letrend/UVen/docs/photo_2023-08-14_19-41-47.jpg

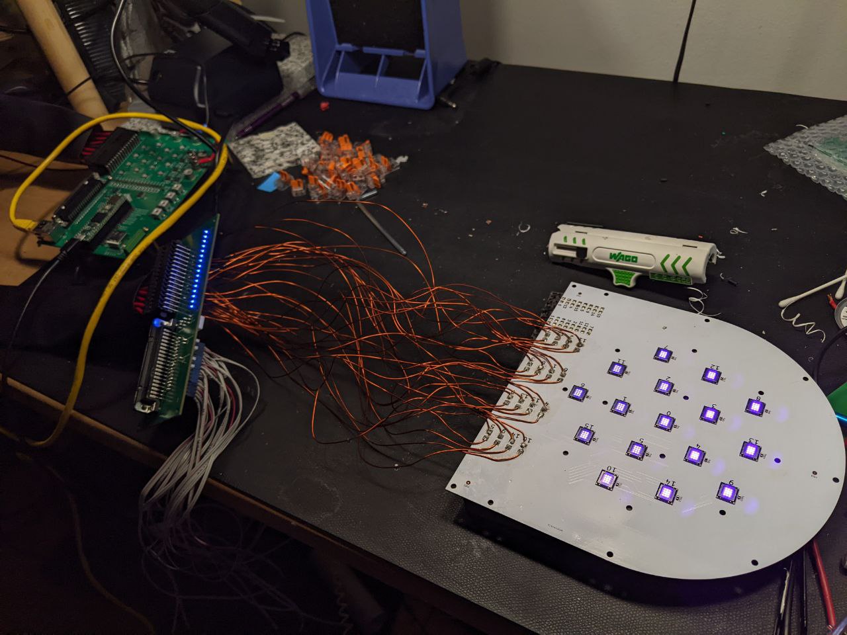
docs/photo_2023-08-14_19-41-47.jpg
