letrend/UVen/docs/photo_2023-08-14_15-02-16.jpg

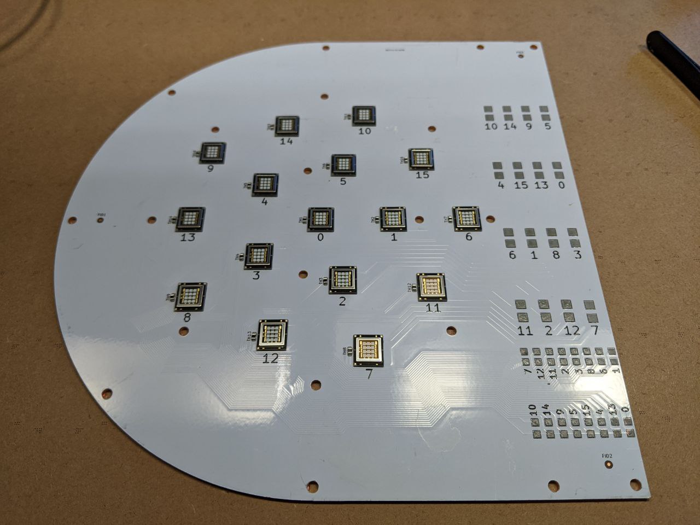
docs/photo_2023-08-14_15-02-16.jpg
