letrend/UVen/README.md

# UVen
UV irradiation system for enhanced photo-activation in living cells
