letrend/UVen/docs/1A.png

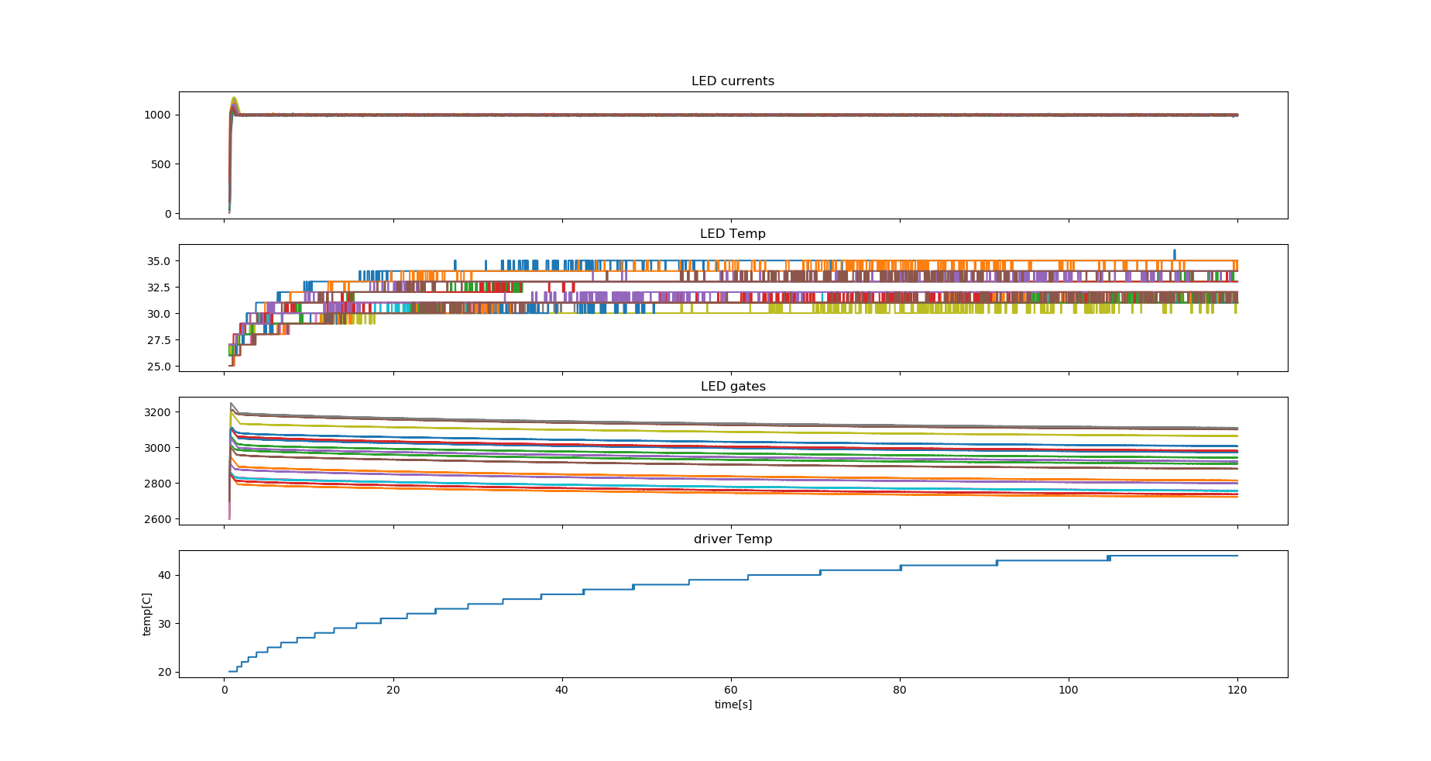
docs/1A.png
