letrend/UVen/docs/2A.png

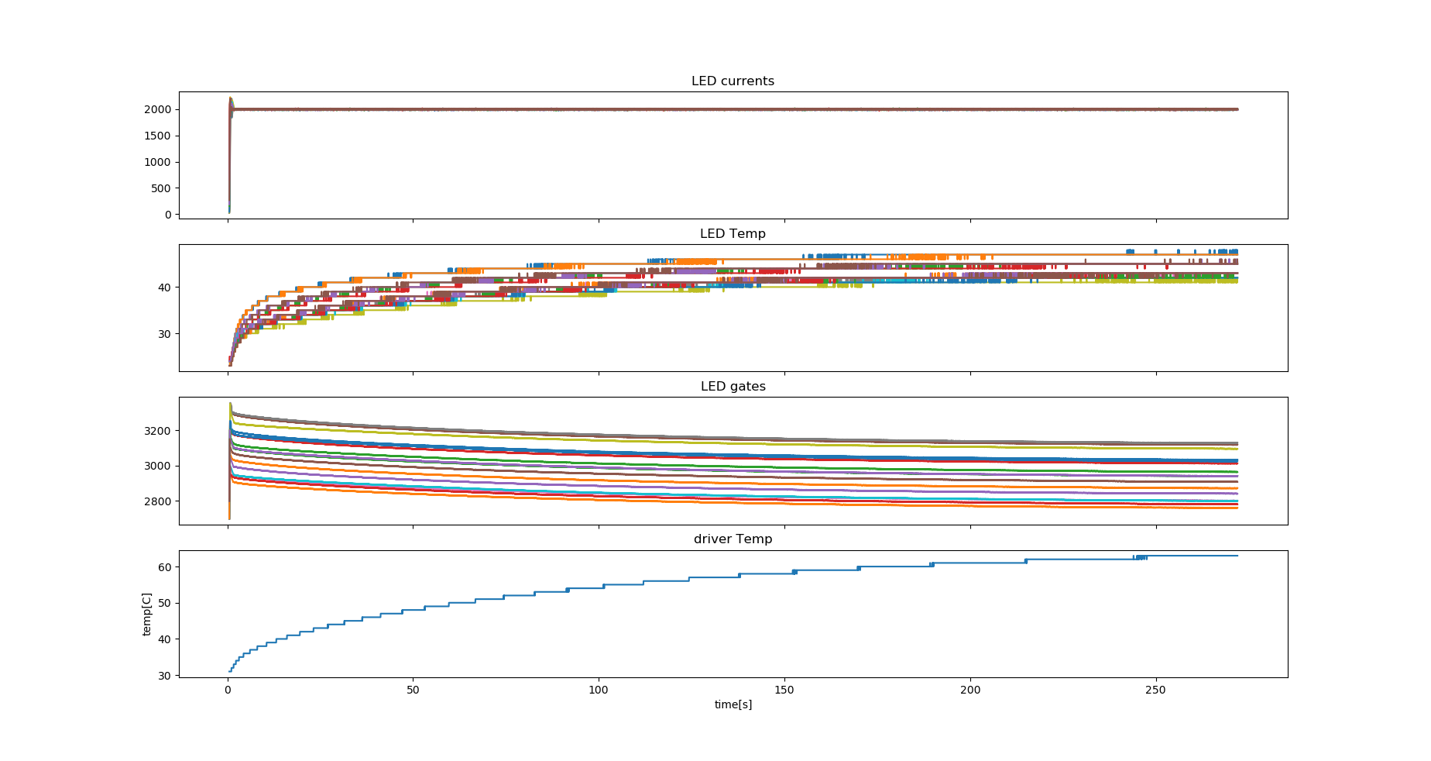
docs/2A.png
