letrend/UVen/docs/display_control.png

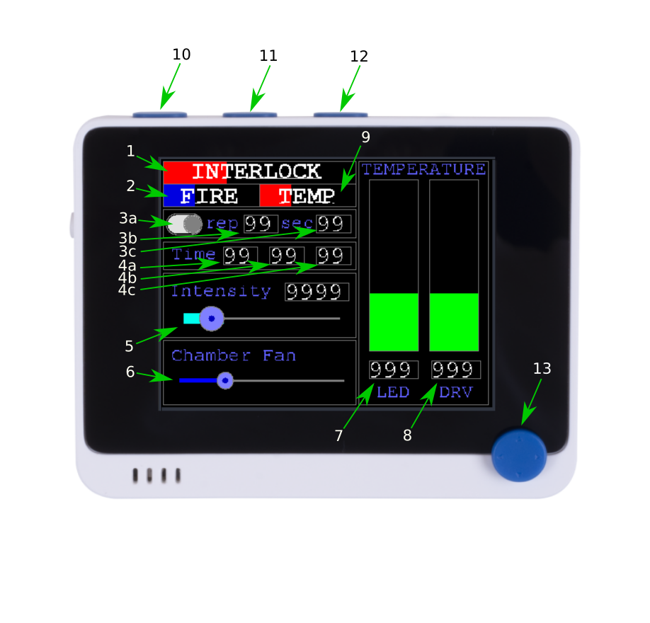
docs/display_control.png
