letrend/UVen/docs/max.png

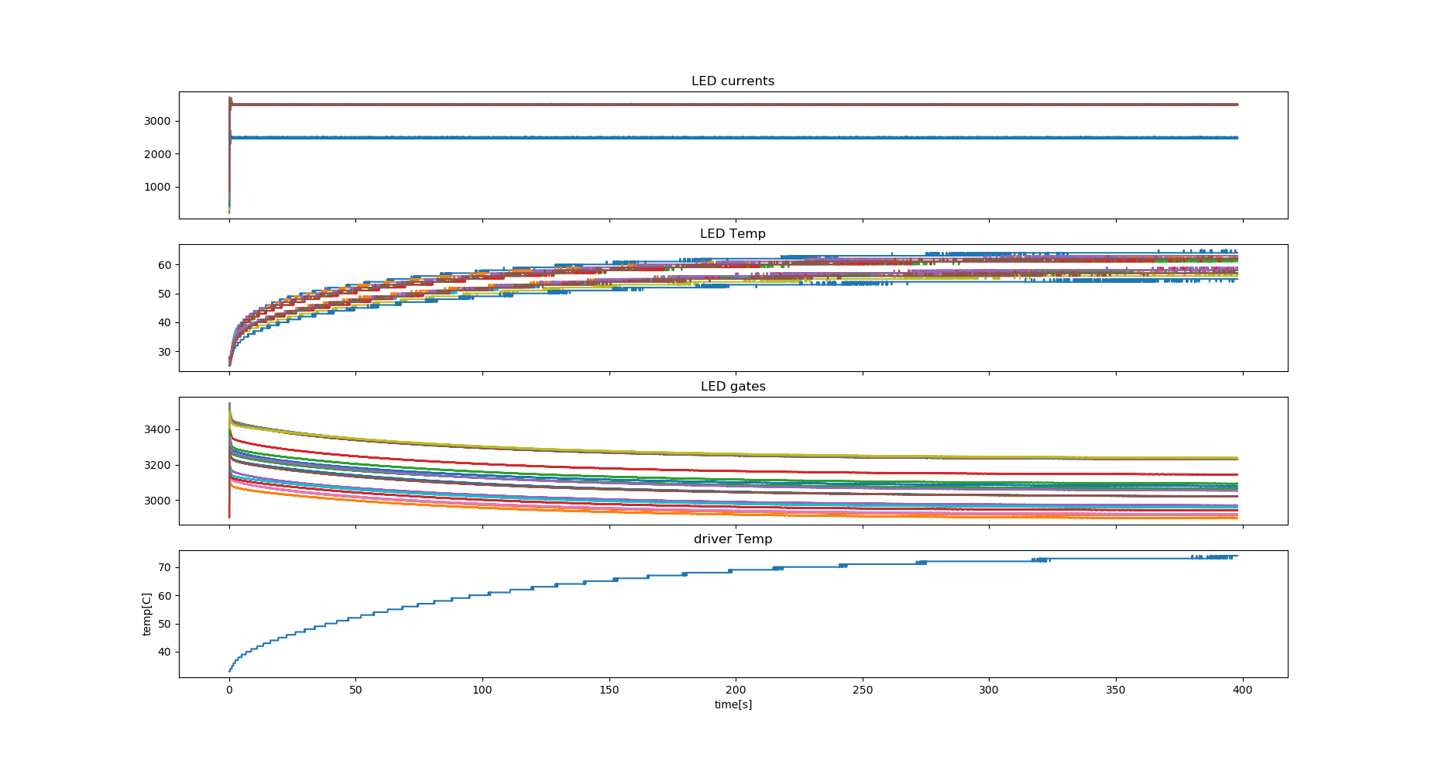
docs/max.png
