letrend/UVen/docs/overTempProtection.png

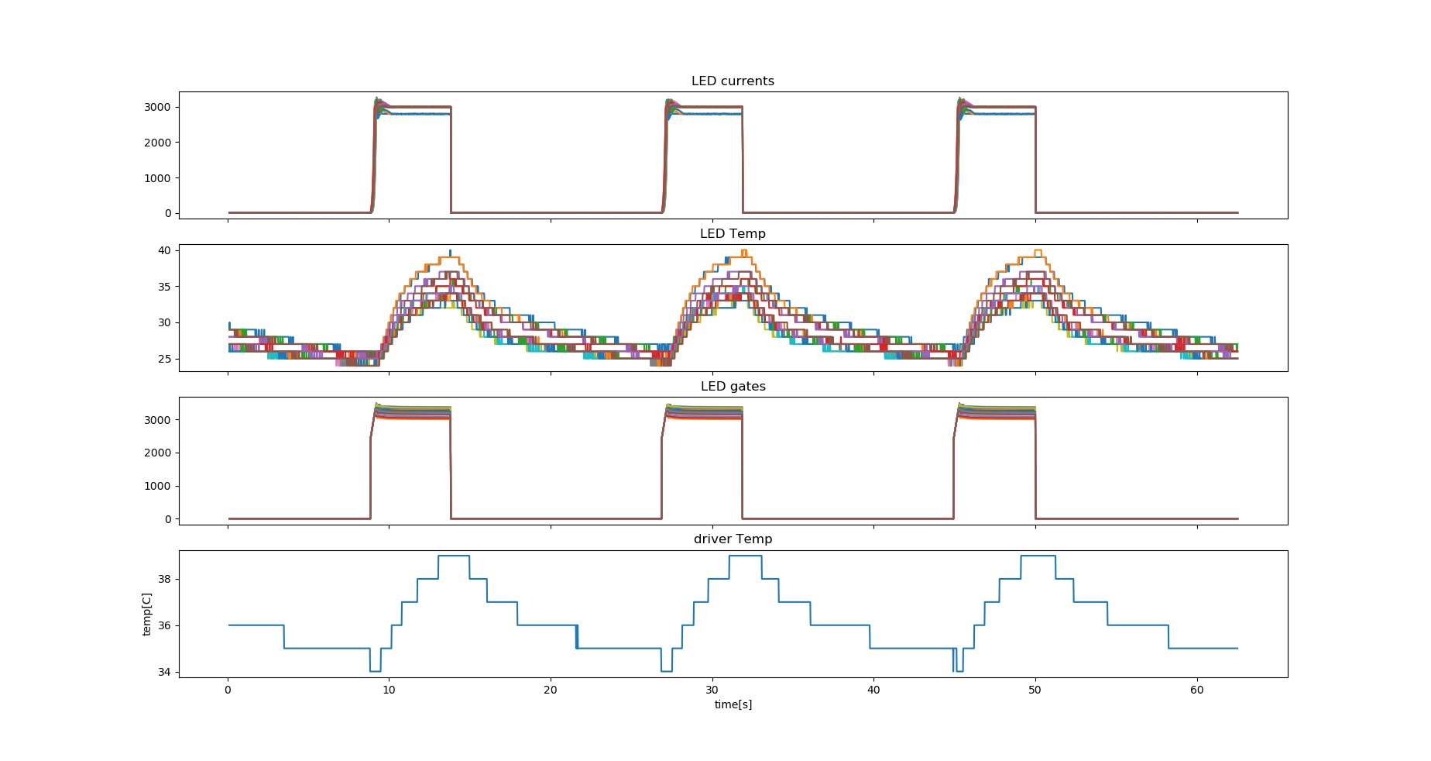
docs/overTempProtection.png
