letrend/UVen/docs/photo_2023-07-25_22-31-44.jpg

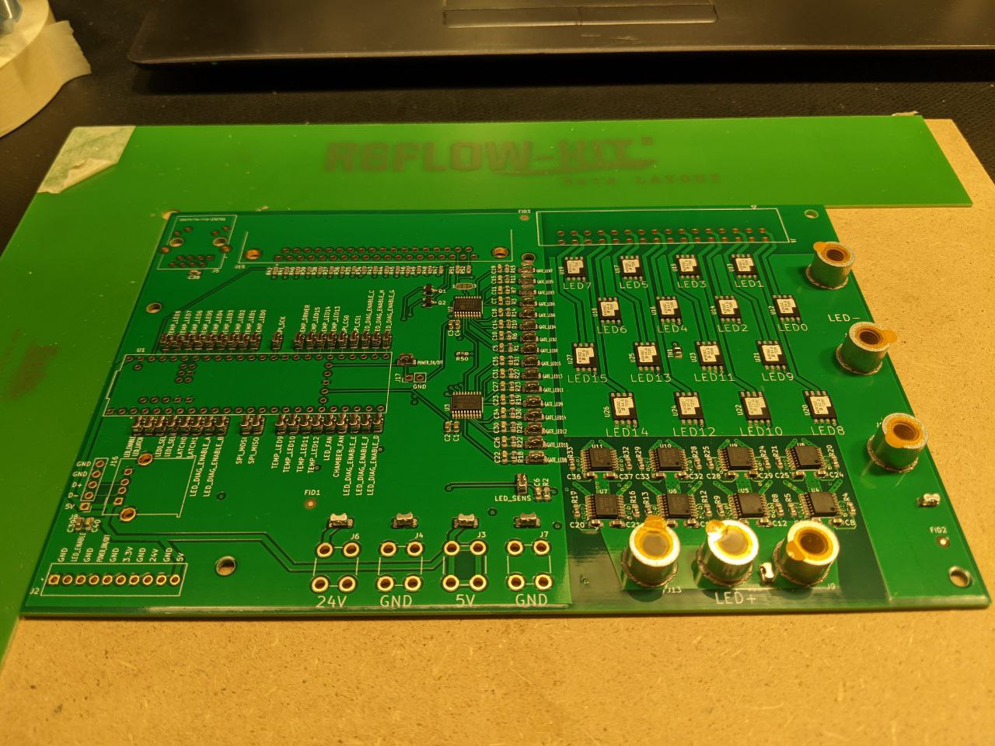
docs/photo_2023-07-25_22-31-44.jpg
