letrend/UVen/docs/photo_2023-07-28_22-57-53.jpg

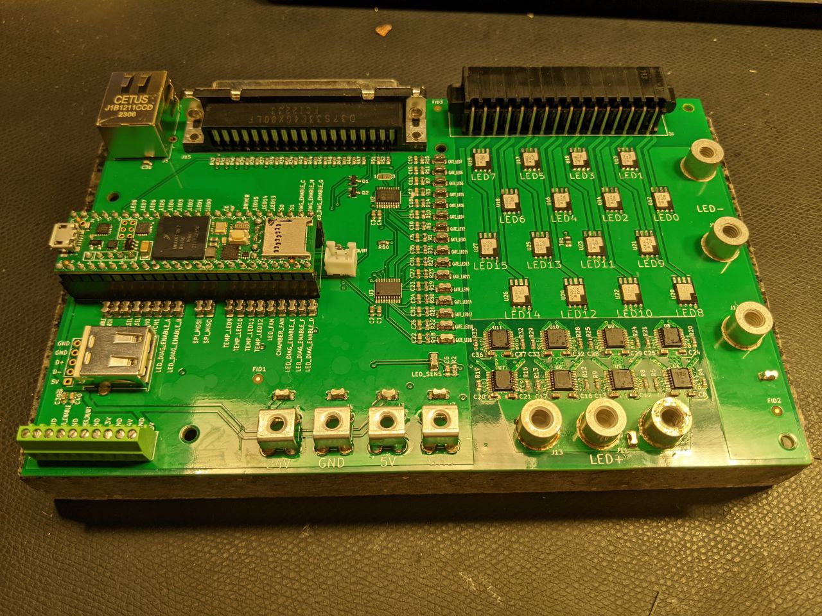
docs/photo_2023-07-28_22-57-53.jpg
