letrend/UVen/docs/photo_2023-07-29_12-32-24.jpg

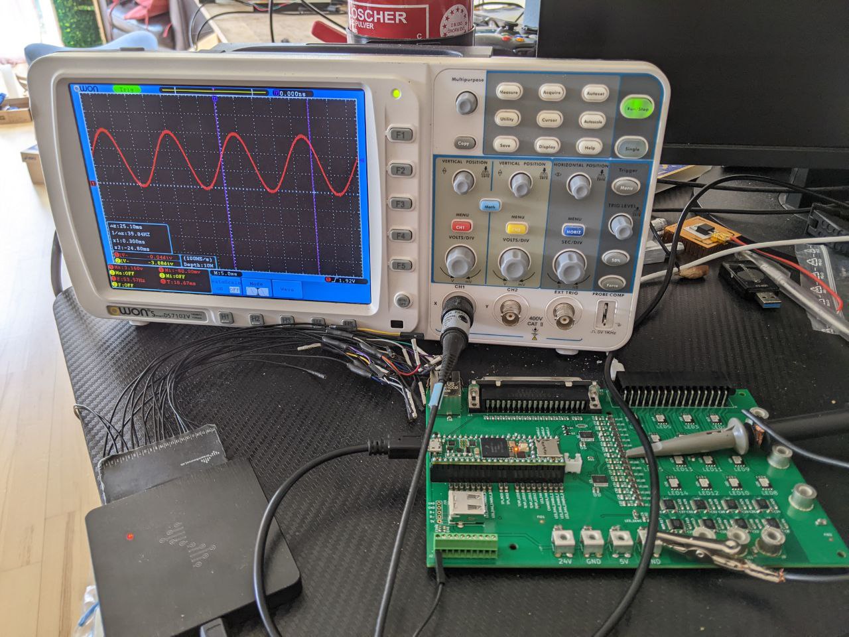
docs/photo_2023-07-29_12-32-24.jpg
