letrend/UVen/docs/photo_2023-07-29_15-54-59.jpg

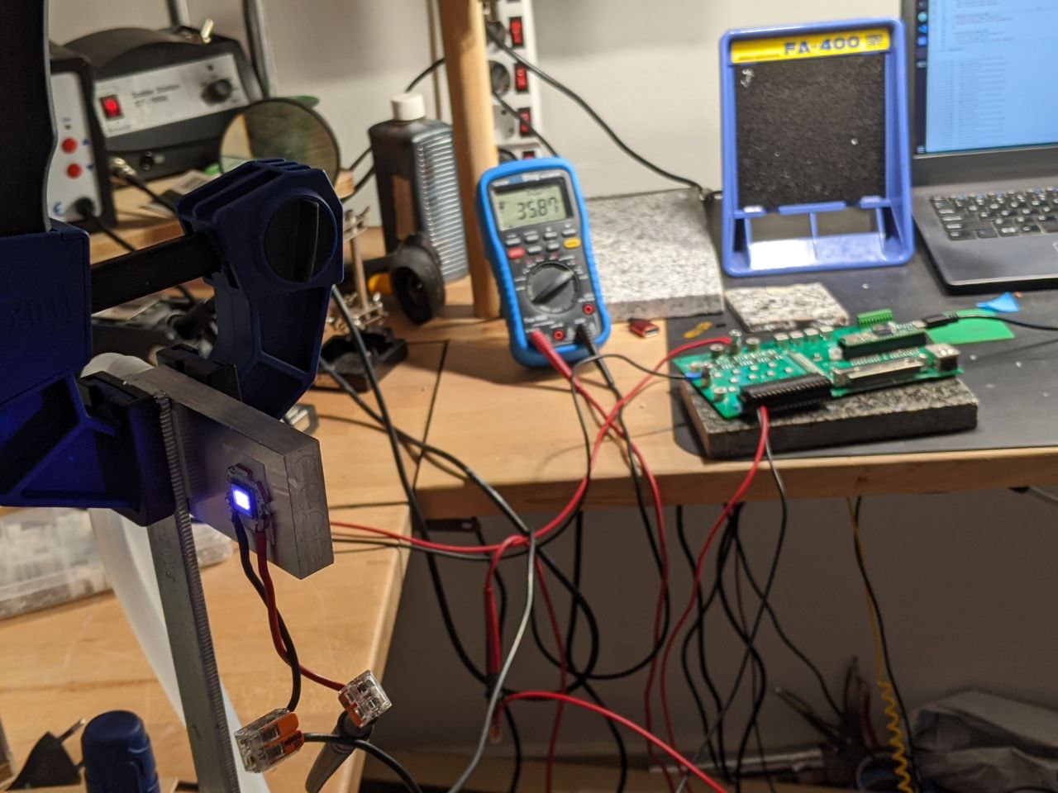
docs/photo_2023-07-29_15-54-59.jpg
