letrend/UVen/docs/photo_2023-07-31_22-14-31.jpg

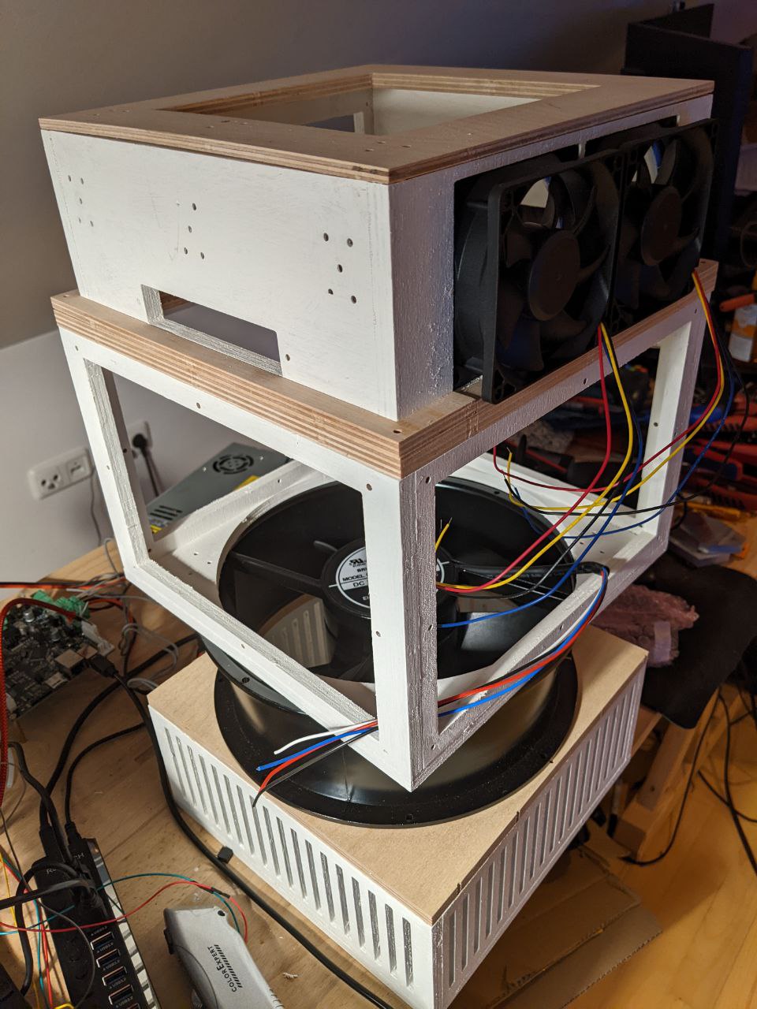
docs/photo_2023-07-31_22-14-31.jpg
