letrend/UVen/docs/photo_2023-08-09_19-29-06 (2).jpg

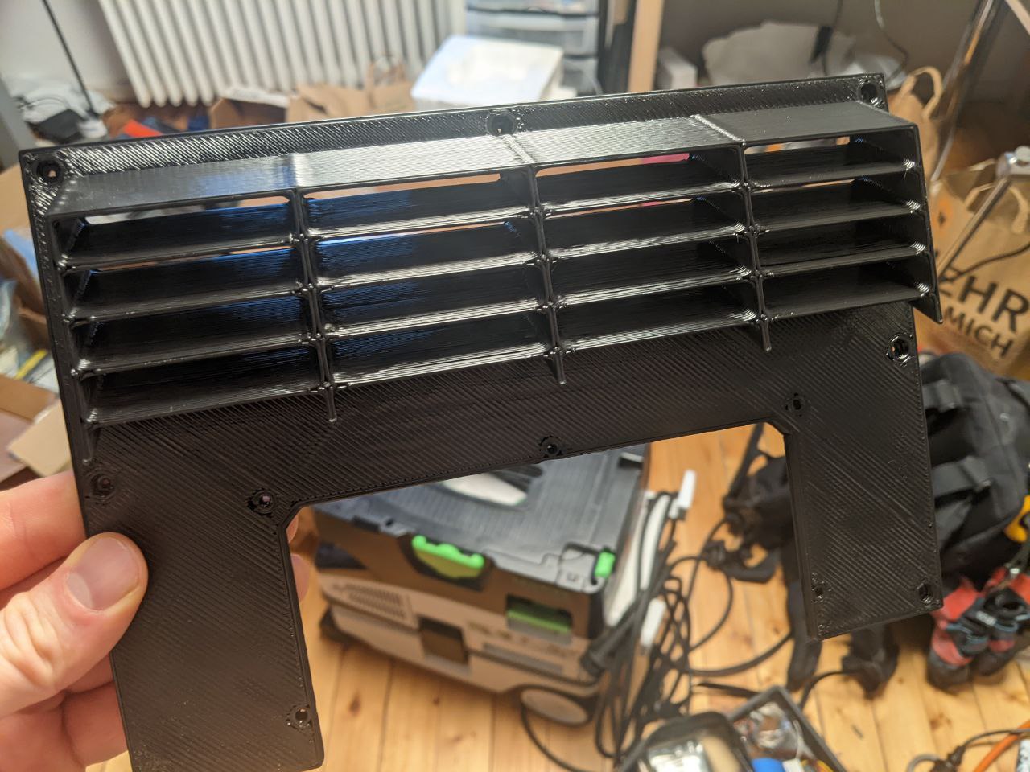
docs/photo_2023-08-09_19-29-06 (2).jpg
