letrend/UVen/docs/photo_2023-08-09_19-29-06.jpg

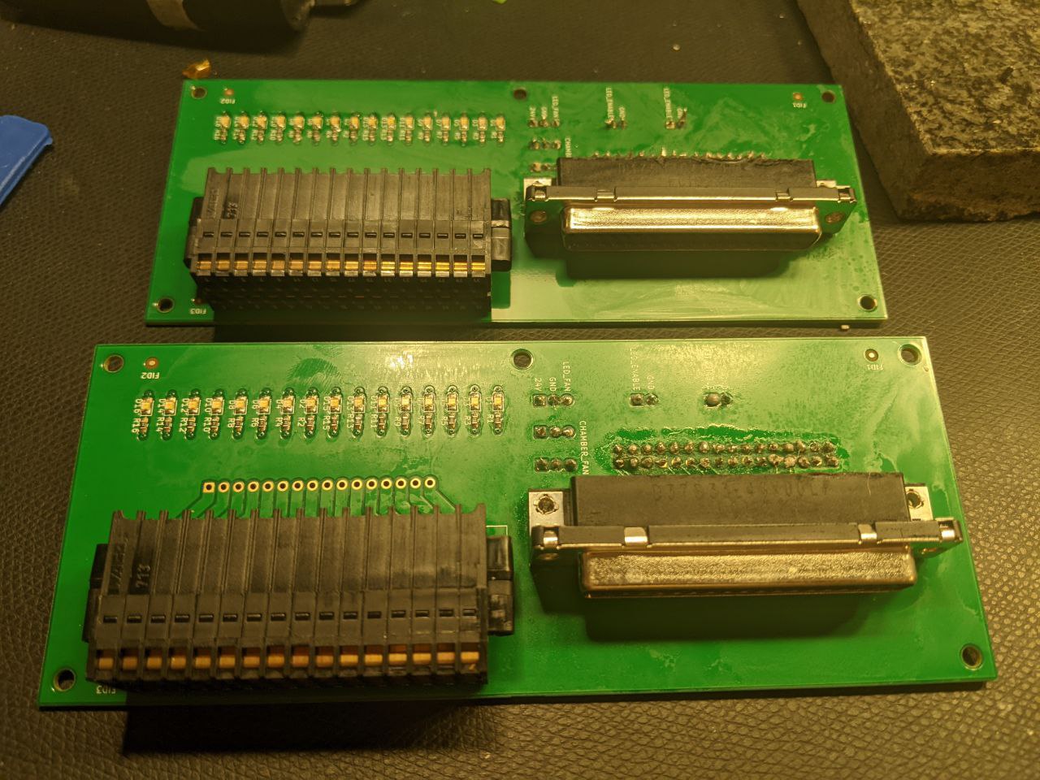
docs/photo_2023-08-09_19-29-06.jpg
