letrend/UVen/docs/photo_2023-08-09_21-17-47.jpg

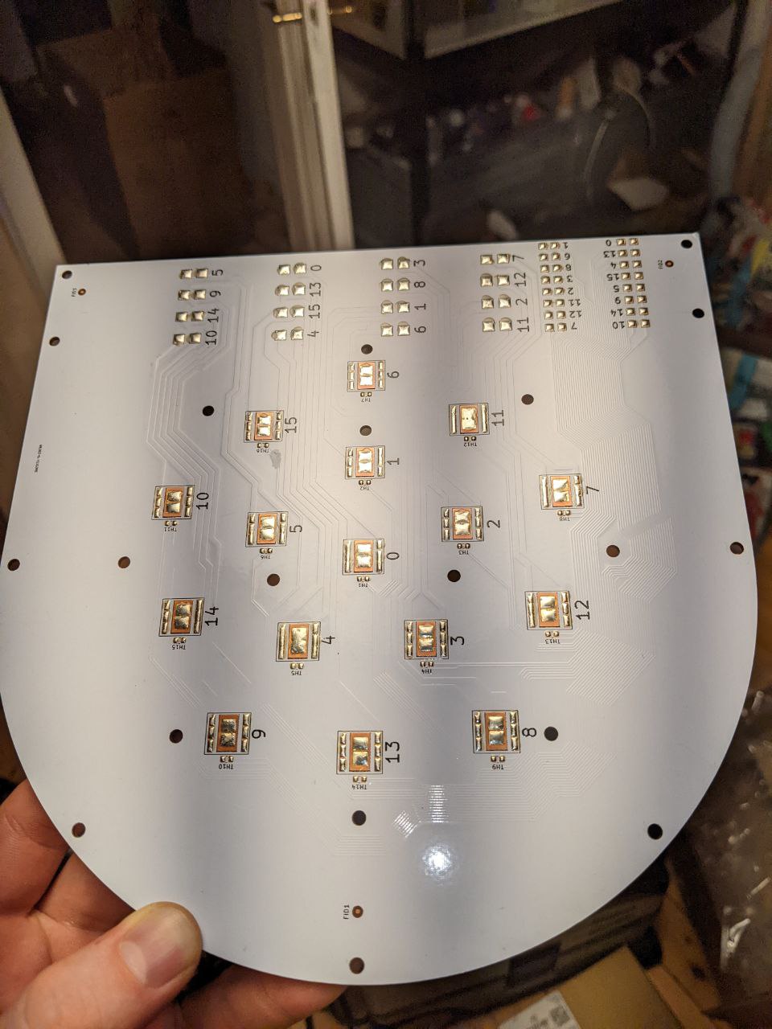
docs/photo_2023-08-09_21-17-47.jpg
