letrend/UVen/docs/photo_2023-08-14_11-19-50.jpg

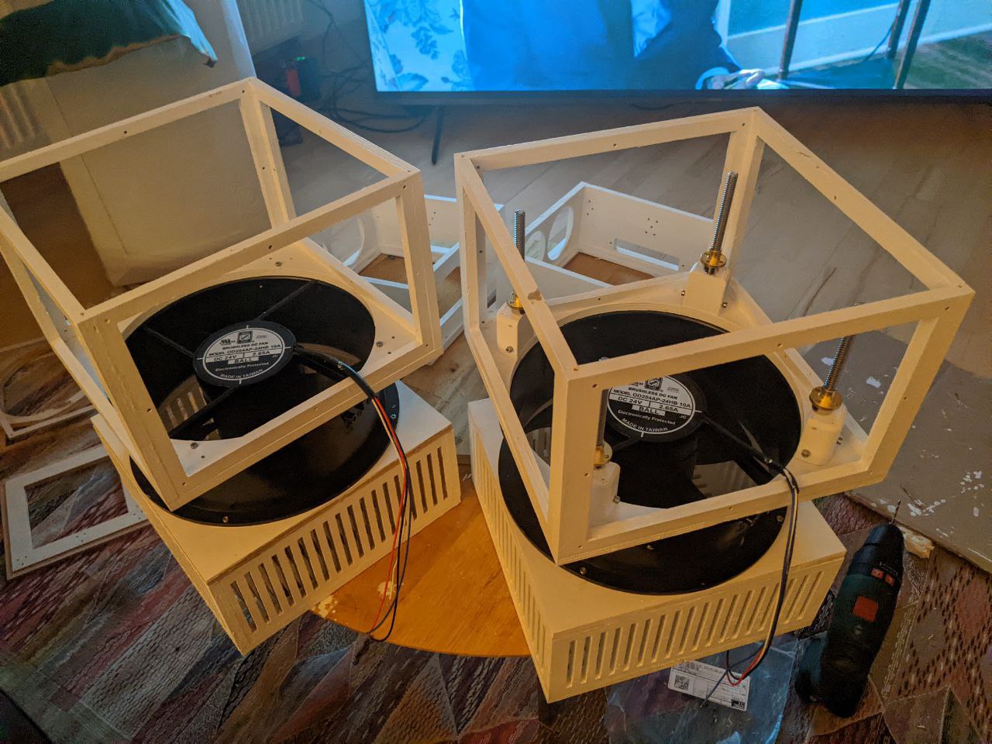
docs/photo_2023-08-14_11-19-50.jpg
