letrend/UVen/docs/photo_2023-08-14_11-21-11.jpg

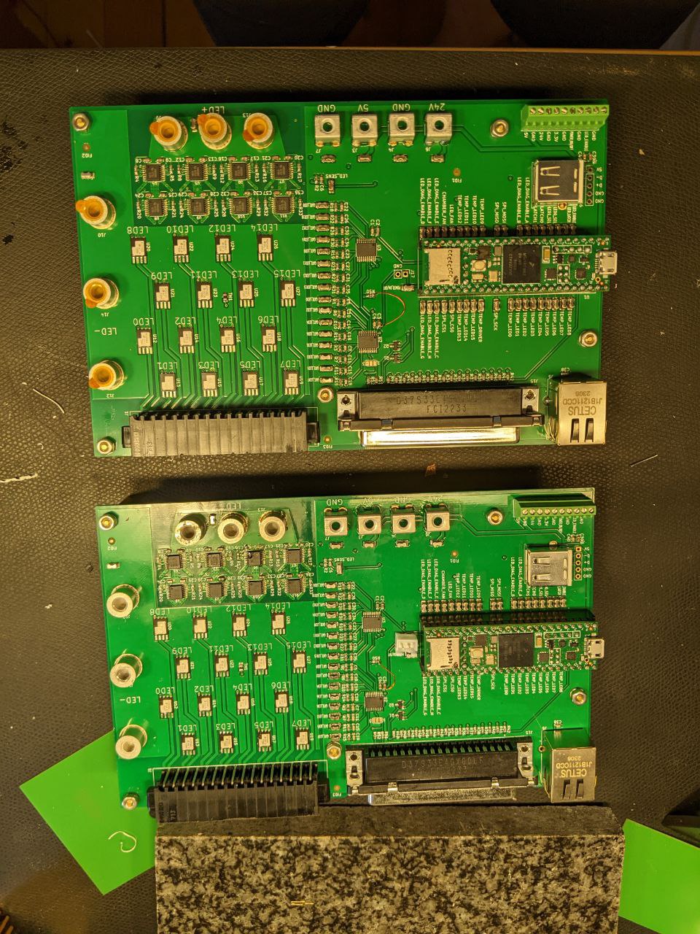
docs/photo_2023-08-14_11-21-11.jpg
