letrend/UVen/docs/photo_2023-08-14_14-28-31.jpg

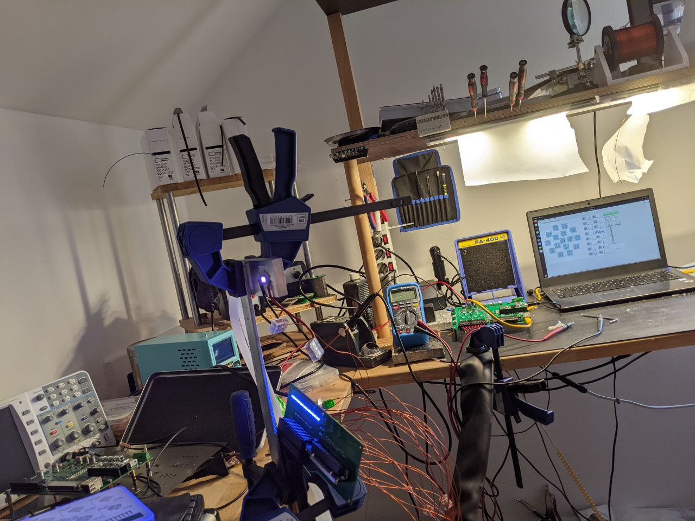
docs/photo_2023-08-14_14-28-31.jpg
