letrend/UVen/docs/photo_2023-08-15_13-29-59 (2).jpg

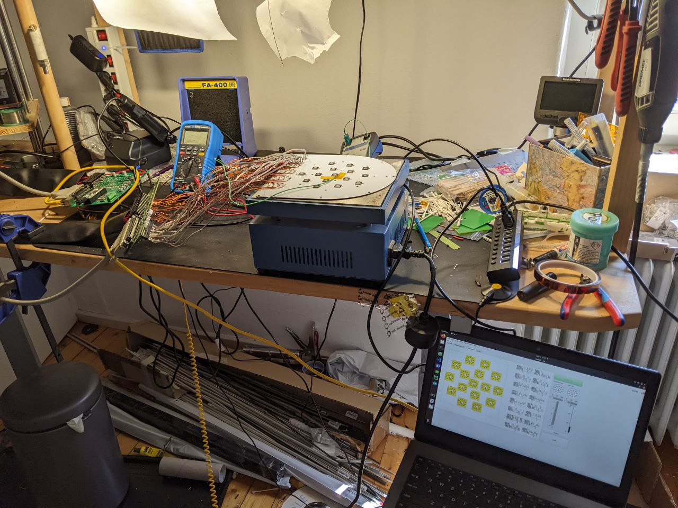
docs/photo_2023-08-15_13-29-59 (2).jpg
