letrend/UVen/docs/photo_2023-08-15_15-07-47.jpg

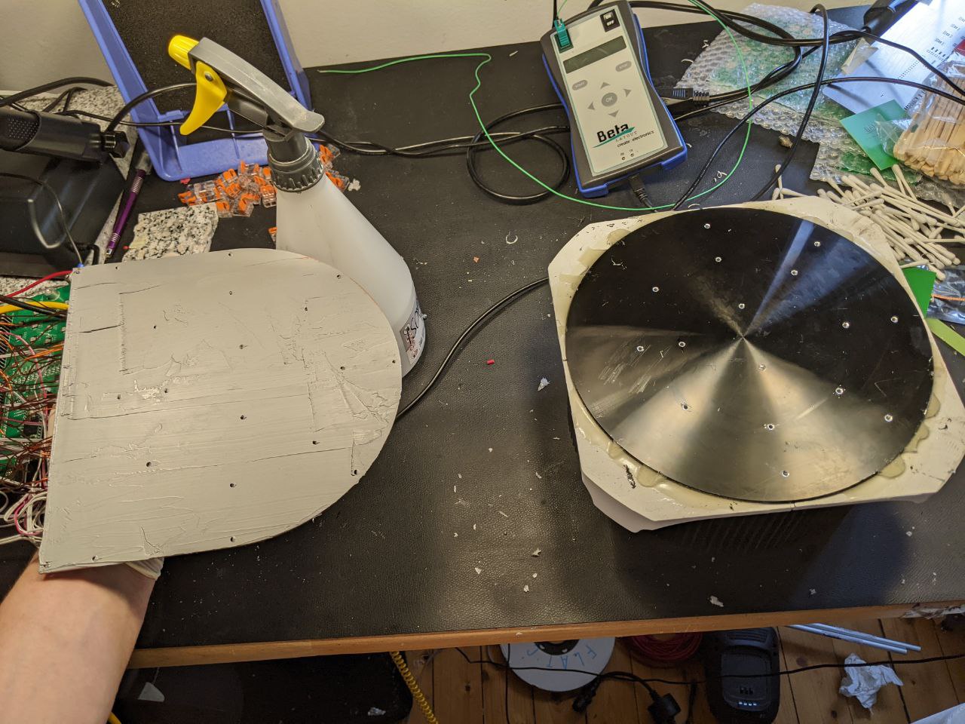
docs/photo_2023-08-15_15-07-47.jpg
