letrend/UVen/docs/photo_2023-08-15_15-56-15.jpg

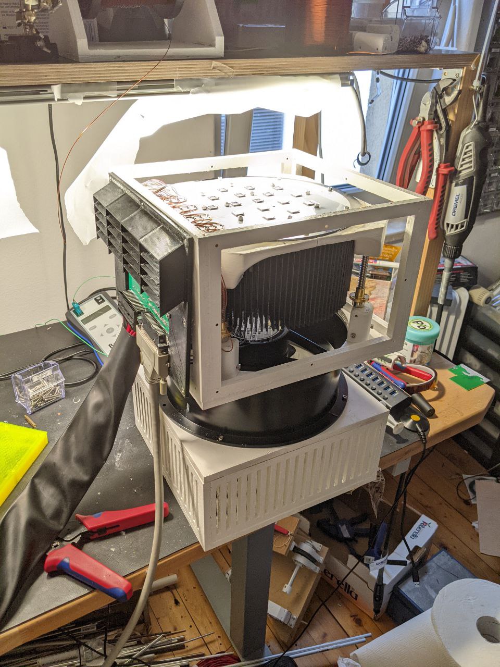
docs/photo_2023-08-15_15-56-15.jpg
