letrend/UVen/docs/photo_2023-08-15_16-40-28.jpg

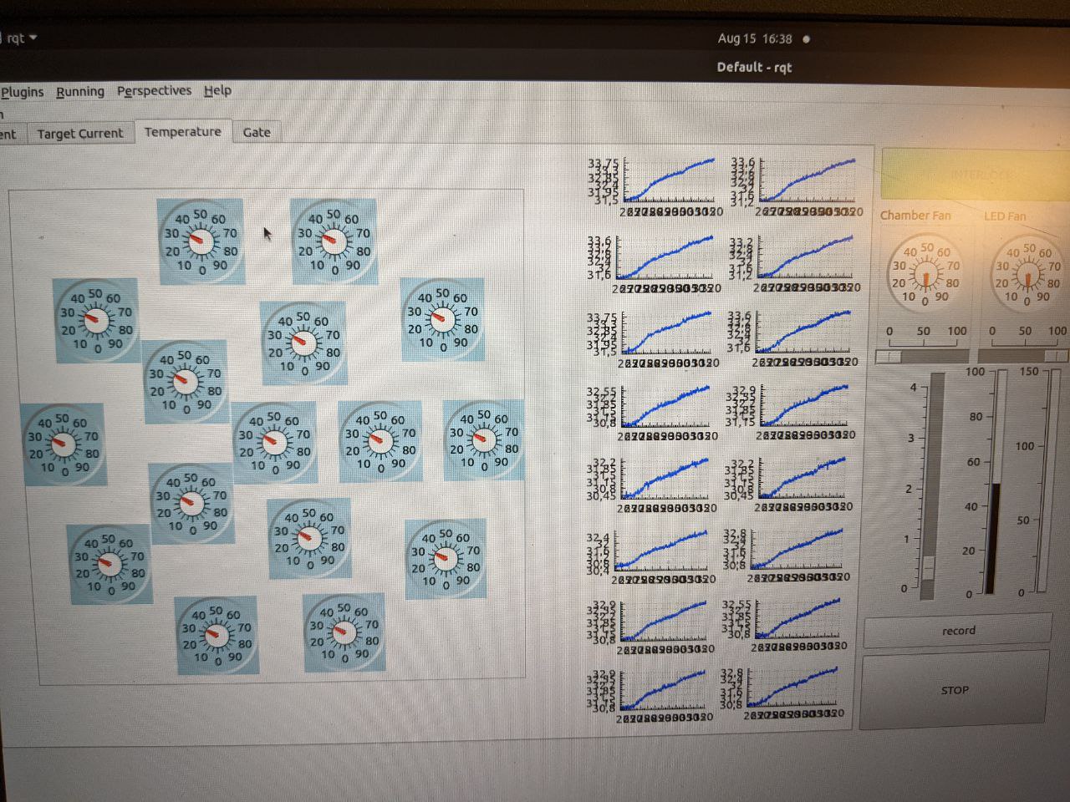
docs/photo_2023-08-15_16-40-28.jpg
