letrend/UVen/docs/photo_2023-08-15_18-18-40 (2).jpg

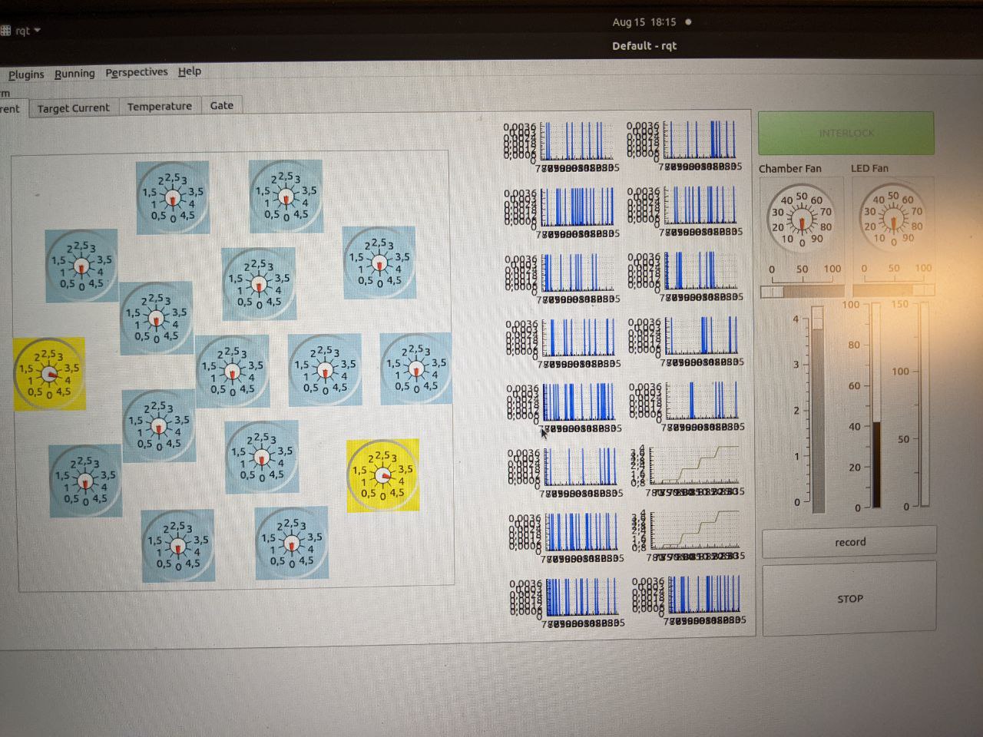
docs/photo_2023-08-15_18-18-40 (2).jpg
