letrend/UVen/docs/photo_2023-08-15_19-15-47.jpg

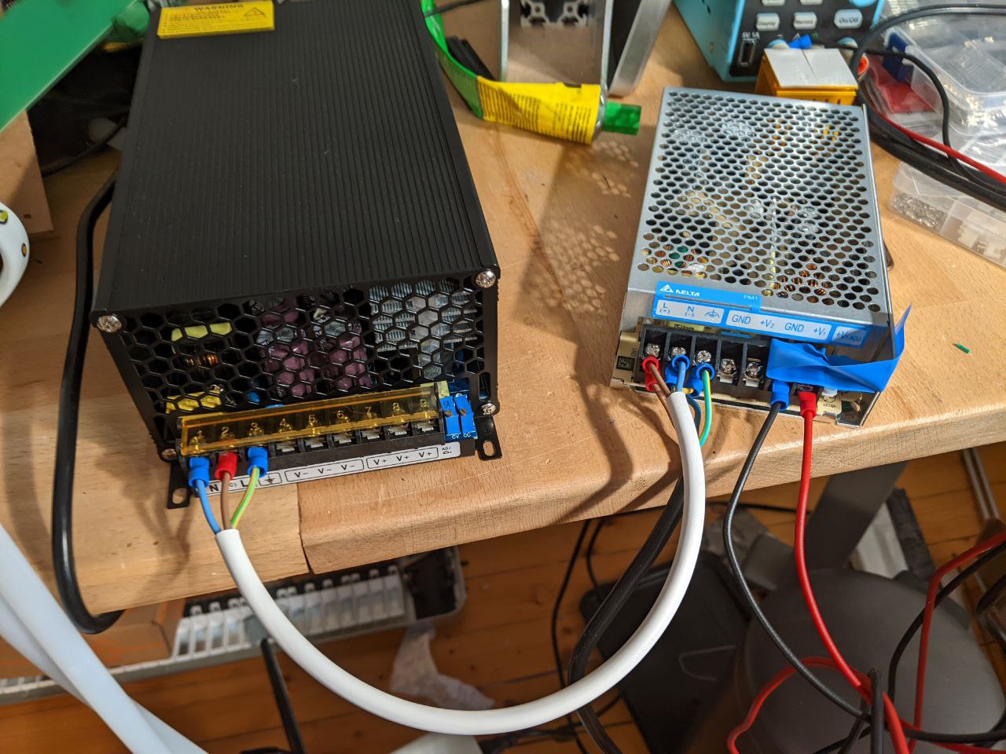
docs/photo_2023-08-15_19-15-47.jpg
