letrend/UVen/docs/photo_2023-08-16_20-38-40.jpg

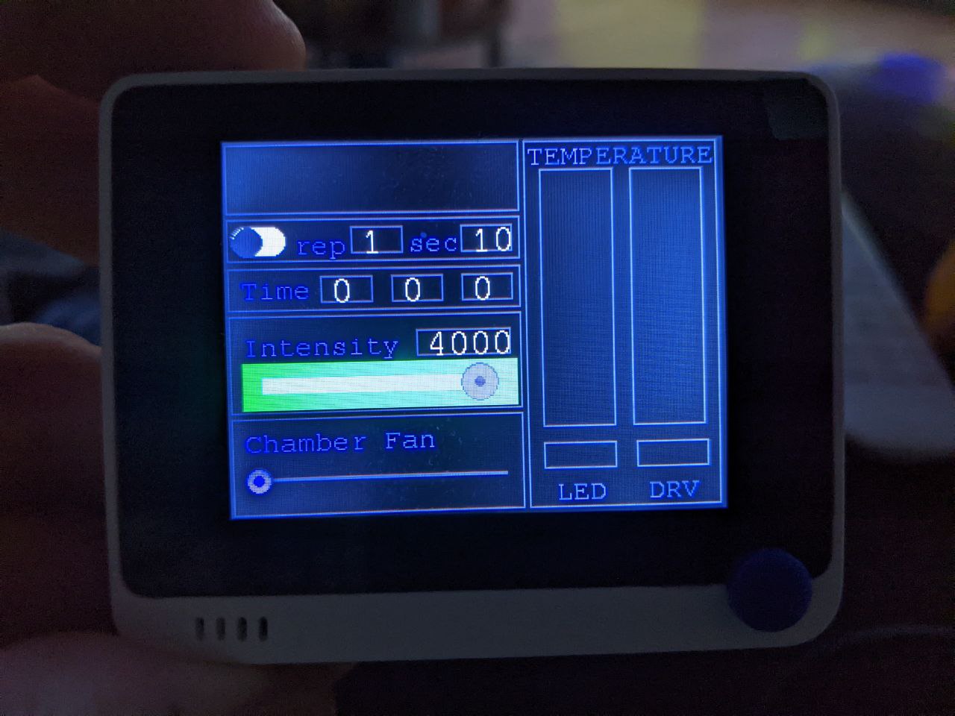
docs/photo_2023-08-16_20-38-40.jpg
