letrend/UVen/docs/photo_2023-08-20_18-25-43.jpg

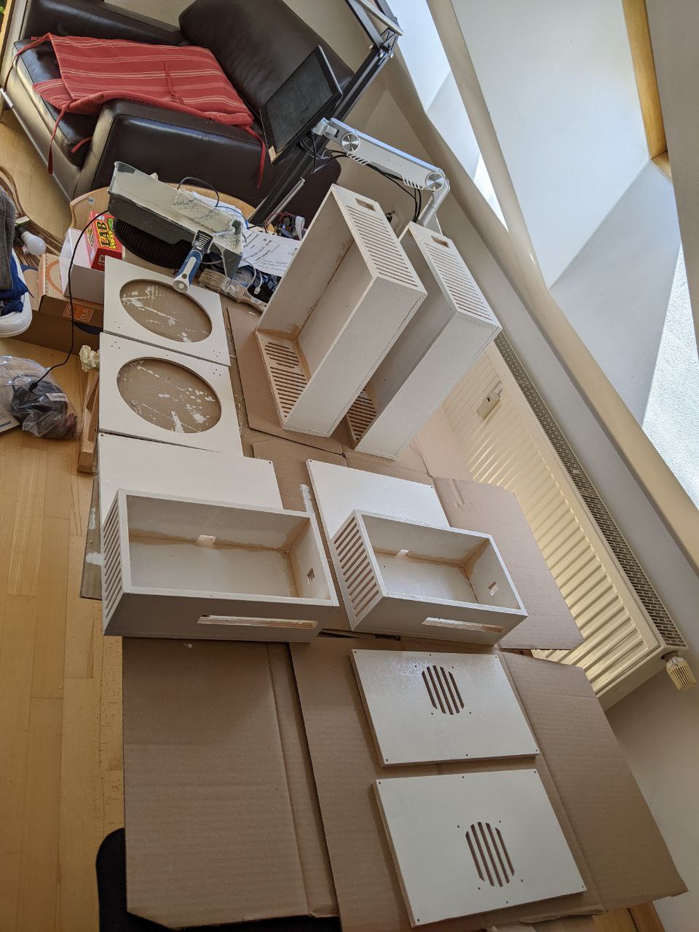
docs/photo_2023-08-20_18-25-43.jpg
