letrend/UVen/docs/photo_2023-08-20_20-09-37.jpg

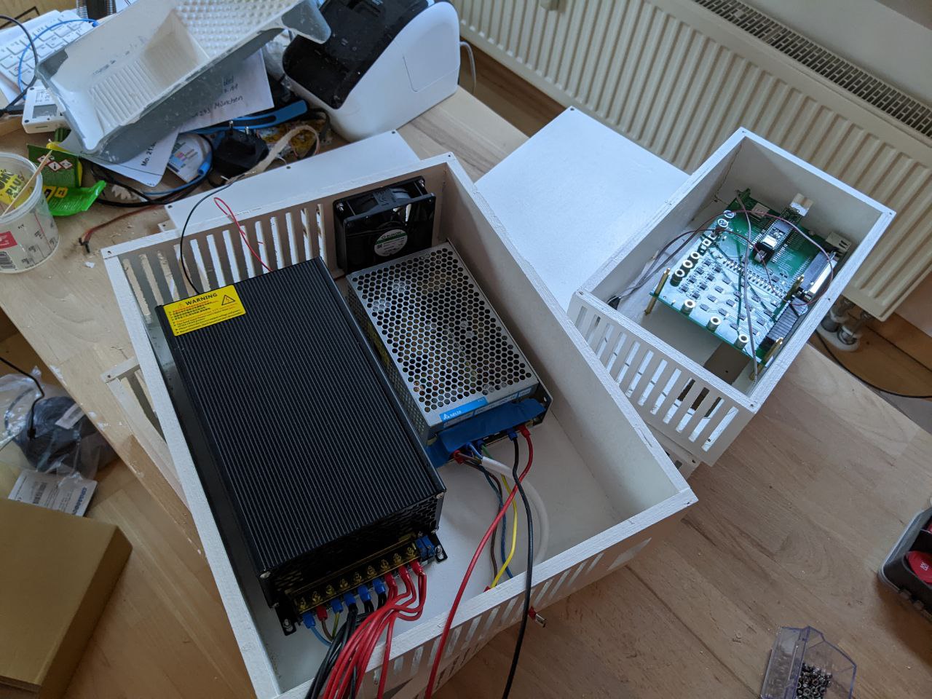
docs/photo_2023-08-20_20-09-37.jpg
