letrend/UVen/docs/photo_2023-08-22_20-38-16.jpg

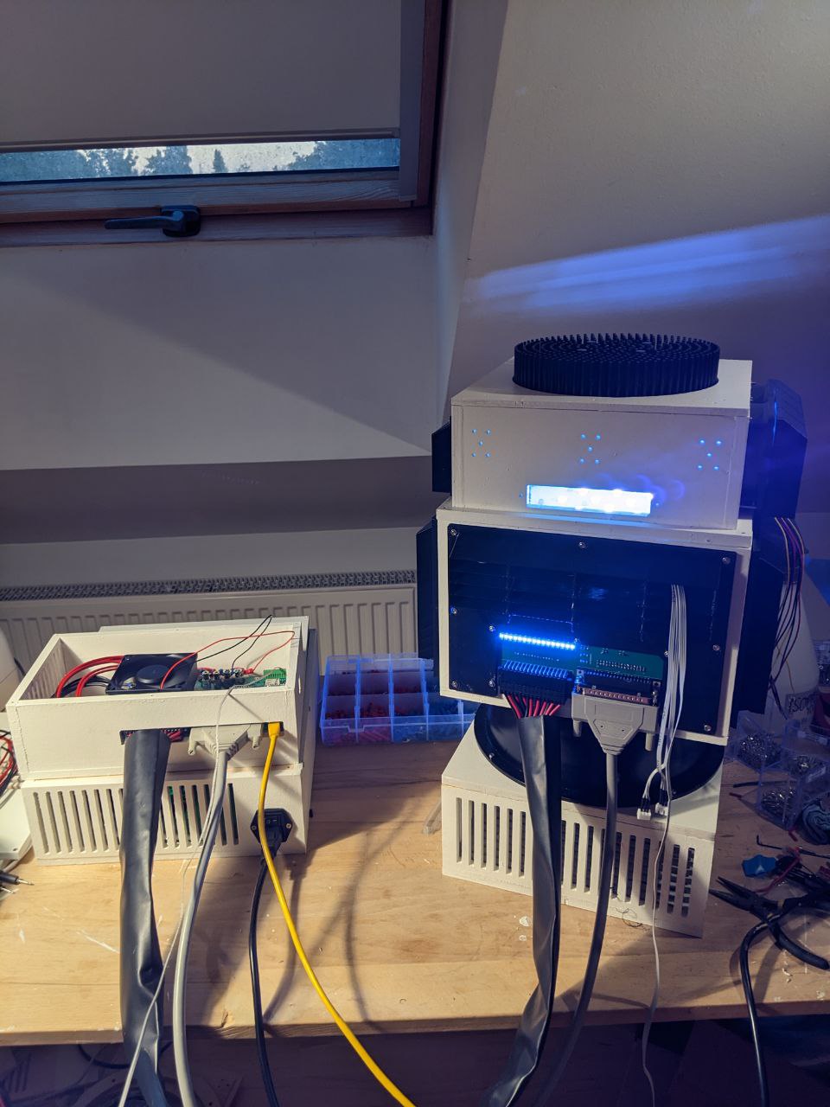
docs/photo_2023-08-22_20-38-16.jpg
