letrend/UVen/docs/photo_2023-08-26_19-12-46.jpg

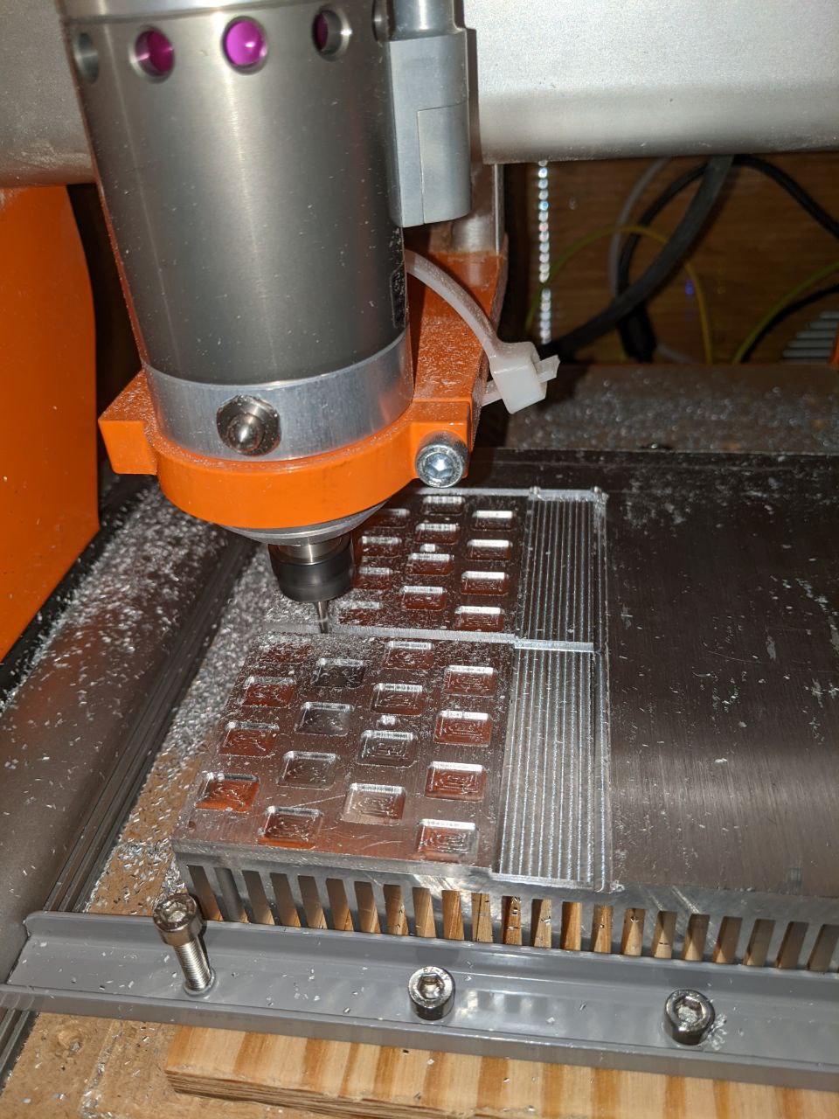
docs/photo_2023-08-26_19-12-46.jpg
