letrend/UVen/docs/photo_2023-08-26_20-18-00 (2).jpg

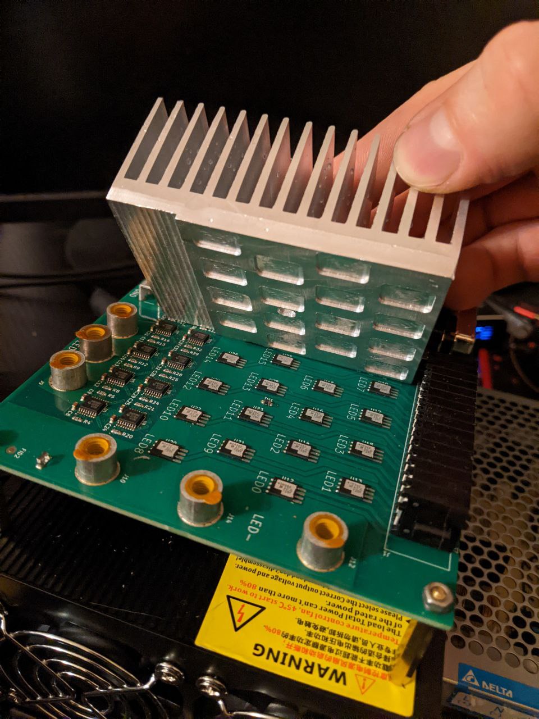
docs/photo_2023-08-26_20-18-00 (2).jpg
