letrend/UVen/docs/photo_2023-08-26_20-18-00.jpg

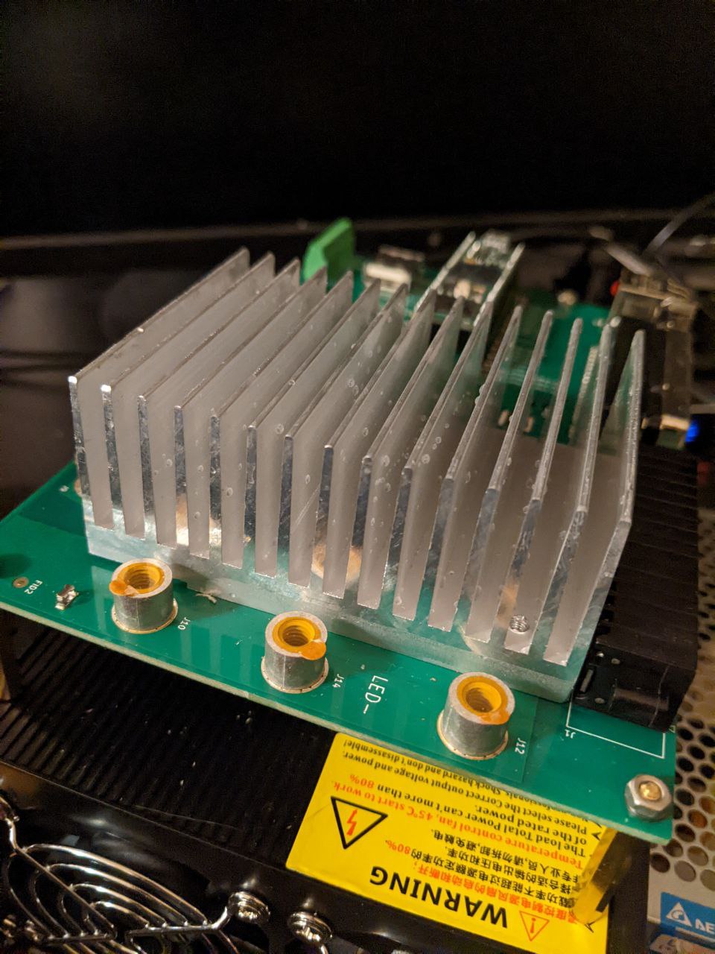
docs/photo_2023-08-26_20-18-00.jpg
