letrend/UVen/docs/photo_2023-08-26_23-55-58.jpg

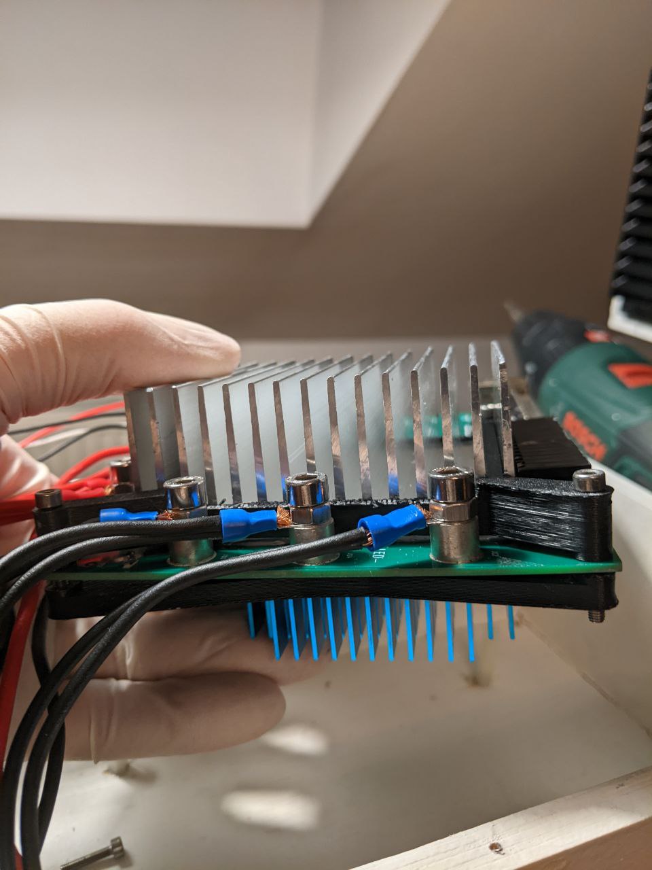
docs/photo_2023-08-26_23-55-58.jpg
