letrend/UVen/docs/photo_2023-08-27_11-00-27.jpg

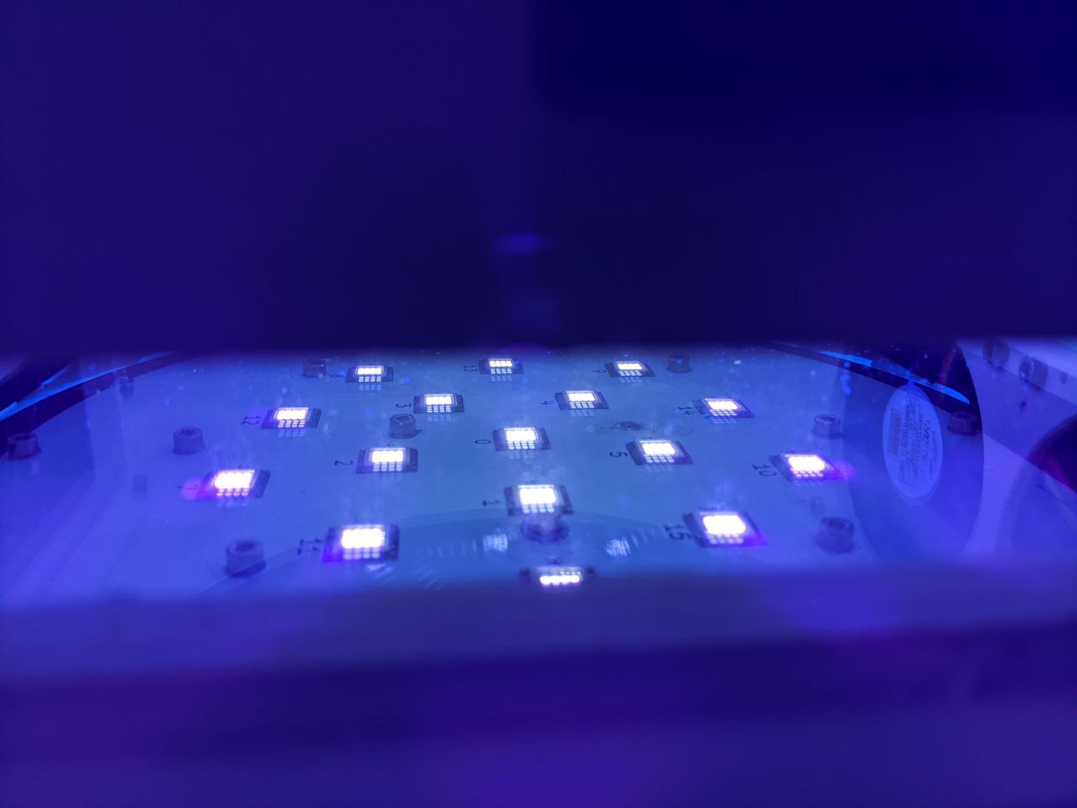
docs/photo_2023-08-27_11-00-27.jpg
