letrend/UVen/docs/photo_2023-08-27_14-05-15.jpg

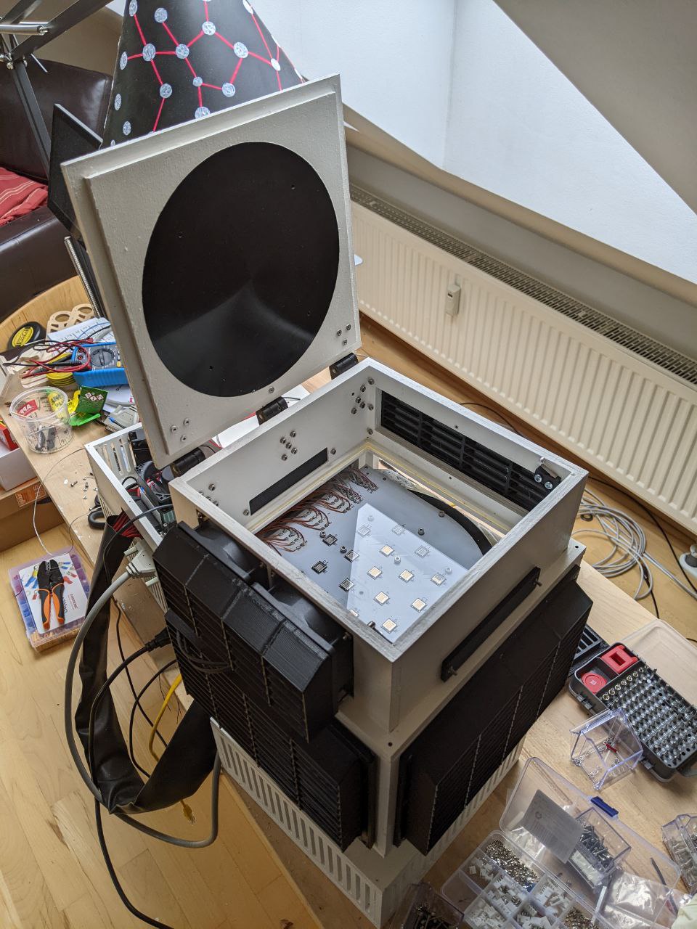
docs/photo_2023-08-27_14-05-15.jpg
