letrend/UVen/docs/photo_2023-08-27_18-15-50(3).jpg

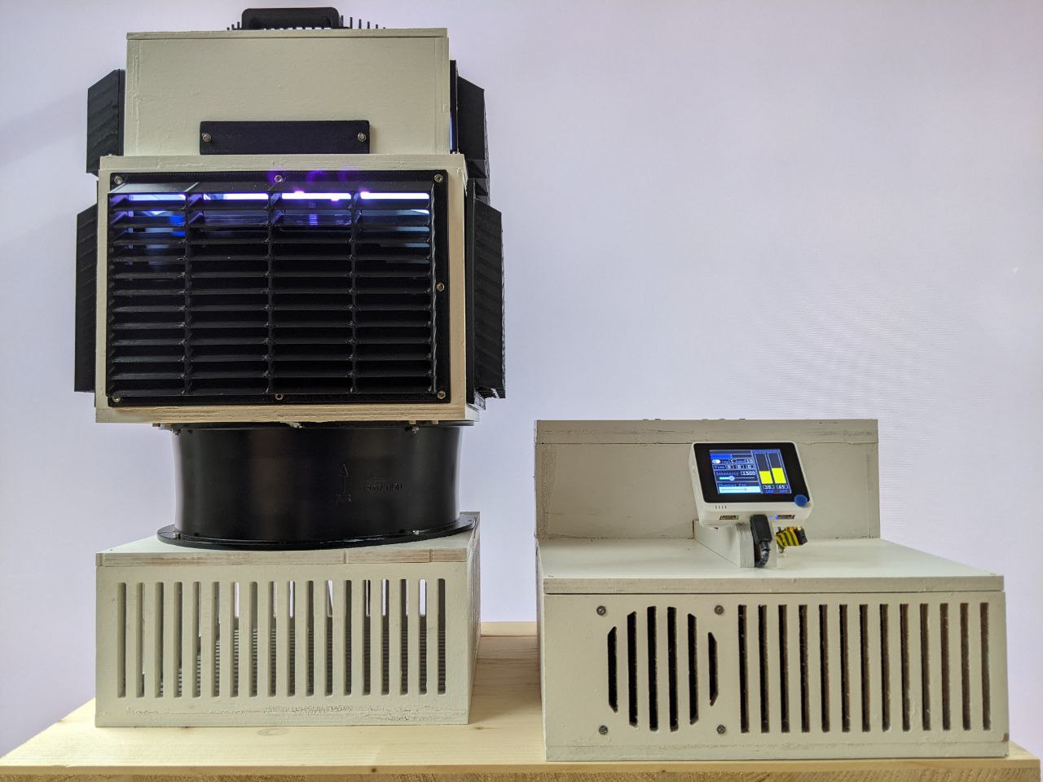
docs/photo_2023-08-27_18-15-50(3).jpg
