letrend/UVen/docs/uven2_mk2_interface_board.png

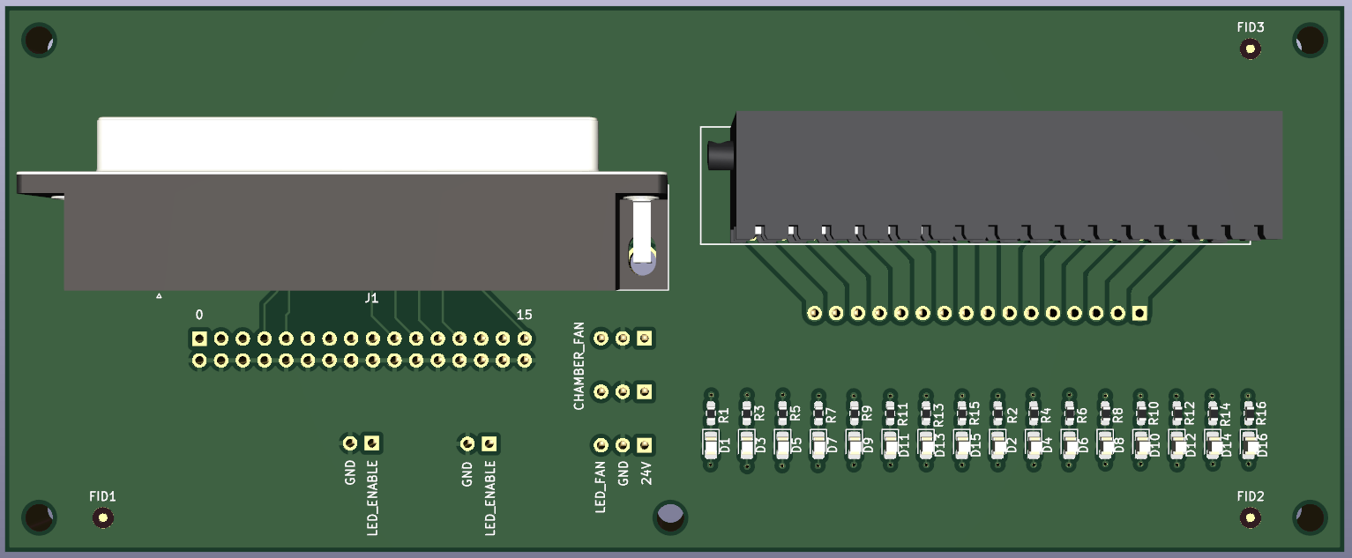
docs/uven2_mk2_interface_board.png
