letrend/UVen/docs/uven2_mk2_led_pcb.png

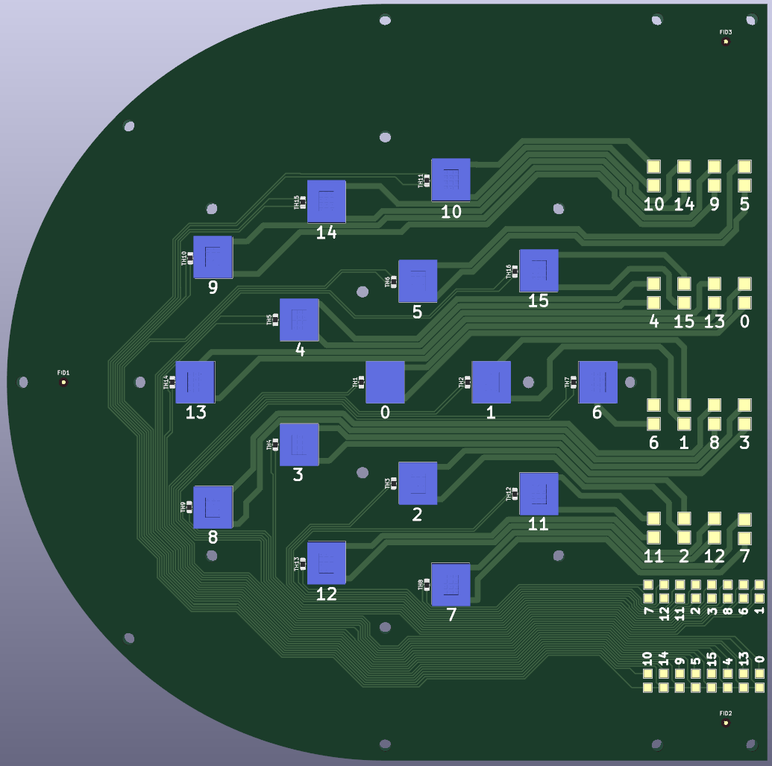
docs/uven2_mk2_led_pcb.png
