letrend/UVen/docs/uven2_mk2_mainboard.png

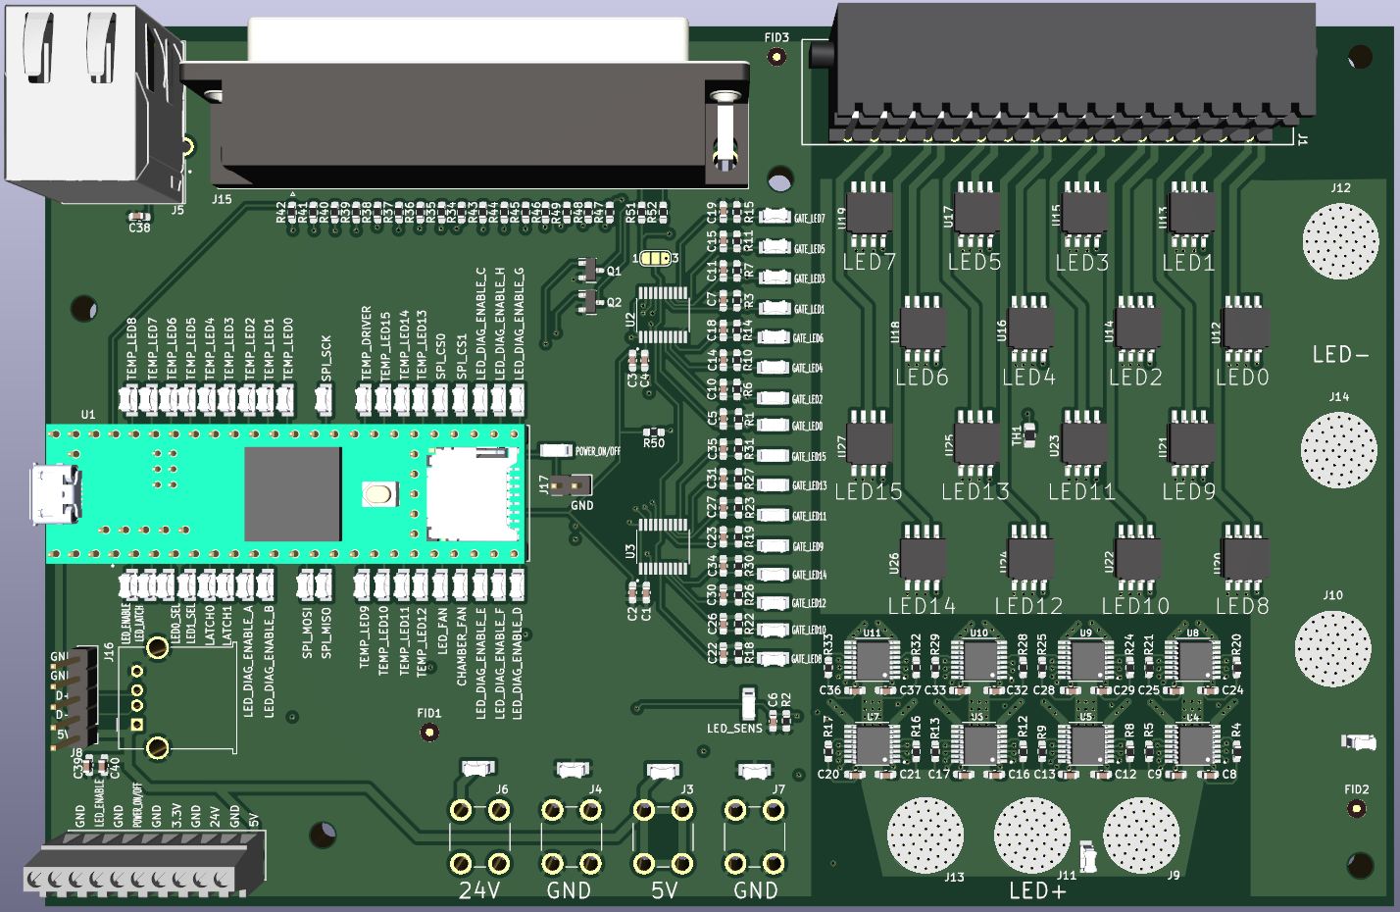
docs/uven2_mk2_mainboard.png
