letrend/UVen/hardware/uven2_mk2.ods

Part | Cost per Part | Amount | Total Costs | Link
Orion Fan | 111.06 € | 1 | 111.06 € | https://www.digikey.de/de/products/detail/orion-fans/OD254AP-24HB10A/9679262
Chamber Fans | 14.00 € | 2 | 28.00 € | https://www.digikey.de/de/products/detail/mechatronics-fan-group/MR8025E24B1-6-FSR/7606118
Heat Sink | 188.96 € | 1 | 188.96 € | https://www.digikey.de/de/products/detail/wakefield-vette/PADLED-225100/10414934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
3D Filament | 59.99 € | 1 | 59.99 € | https://www.3djake.de/polymaker/polyterra-pla-charcoal-black?sai=14371#reviews
DAC 8-Channel | 11.04 € | 2 | 22.08 € | https://www.digikey.de/de/products/detail/microchip-technology/MCP48FEB28T-20E-ST/12823490
Current Limiting Switch | 2.43 € | 10 | 24.30 € | https://www.digikey.de/de/products/detail/texas-instruments/TPS2HB50BQPWPRQ1/11615940
4.7uF 0603 35V | 0.13 € | 10 | 1.30 € | https://www.digikey.de/de/products/detail/murata-electronics/GRM188R6YA475KE15D/3900468
220nF 0603 35V | 0.14 € | 10 | 1.40 € | https://www.digikey.de/de/products/detail/taiyo-yuden/GMJ107BB7224KAHT/5405533
10k 0603 0.1% | 0.31 € | 40 | 12.24 € | https://www.digikey.de/de/products/detail/yageo/RE0603BRE0710KL/5923093
1k 0603 1% | 0.06 € | 20 | 1.10 € | https://www.digikey.de/de/products/detail/yageo/RT0603FRE071KL/1075188
100nF 16V | 0.15 € | 20 | 2.98 € | https://www.digikey.de/de/products/detail/kyocera-avx/KAM15AR71C104JM/11259328
10uF 16V | 0.24 € | 4 | 0.94 € | https://www.digikey.de/de/products/detail/kyocera-avx/KGM15CR51C106KT/17866320
10nF 0603 50V | 0.18 € | 2 | 0.36 € | https://www.mouser.de/ProductDetail/KYOCERA-AVX/06035F103K4Z4A?qs=YCa%2FAAYMW03%252BIRIN4aN0sw%3D%3D
LED connector | 2.53 € | 1 | 2.53 € | https://www.buerklin.com/en/p/wago/pcb-connection-systems/713-1436-107-000/44P2307/
Teensy 4.1 | 42.99 € | 1 | 42.99 € | https://www.conrad.de/de/p/pjrc-teensy41-mikrocontroller-teensy-4-1-2269230.html?hk=SEM&WT.mc_id=google_pla
pin socket 24pins | 3.50 € | 2 | 7.00 € | https://www.mouser.de/ProductDetail/Samtec/CES-124-01-T-S?qs=0lQeLiL1qyYykmR5AzhKtQ%3D%3D
18V 66.7A 1200Watt Power Supply | 318.77 € | 1 | 318.77 € | https://www.ampul.eu/de/schaltnetzteile/3321-stromversorgung-18v-833a-1500w
MOSFET SIDR392DP-T1-GE3 | 2.29 € | 20 | 45.80 € | https://www.mouser.de/ProductDetail/Vishay-Semiconductors/SIDR392DP-T1-GE3?qs=y6ZabgHbY%252BxitvpTUsg6jw%3D%3D
Ethernet MagJACK | 3.43 € | 1 | 3.43 € | https://www.digikey.de/de/products/detail/wiznet/J1B1211CCD/7604176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
Flash IC | 1.55 € | 1 | 1.55 € | https://www.digikey.de/de/products/detail/winbond-electronics/W25Q128JVSIQ/5803943
24V 3.5A 5V 3A Power Supply | 43.31 € | 1 | 43.31 € | https://www.mouser.de/ProductDetail/Delta-Electronics/PMT-D2V100W1AA?qs=Paqgc3NkMbQjCGujZptuRw%3D%3D
SMD Terminal with Blind-Hole Thread | 2.62 € | 6 | 15.72 € | https://www.mouser.de/ProductDetail/Wurth-Elektronik/7466205R?qs=lBTPRtX1sU8D2oI%252B7M8jdw%3D%3D
SMD Terminal M4 | 0.42 € | 4 | 1.68 € | https://www.digikey.de/de/products/detail/keystone-electronics/7767/4499347?productid=4499347
SMD screw terminal 10pos | 8.52 € | 1 | 8.52 € | https://www.mouser.de/ProductDetail/TE-Connectivity/1-282834-0?qs=A%252Bip%252BNCYi6NR8gc1VpOgPg%3D%3D
D-Sub 37pos SMD male | 3.81 € | 1 | 3.81 € | https://www.digikey.de/de/products/detail/amphenol-icc-(fci)/D37S33E4GX00LF/1539070?productid=1539070
WIO terminal | 47.60 € | 1 | 47.60 € | https://eckstein-shop.de/SeeedStudioWioTerminal3AATSAMD51CorewithRealtekRTL8720DNBLE5026Wi-Fi24G2F5GDevBoardEN
Test Points | 0.10 € | 100 | 9.52 € | https://www.digikey.de/de/products/detail/koa-speer-electronics-inc/RCWCTE/11476558
NTC Thermistor | 0.58 € | 17 | 9.91 € | https://www.mouser.de/ProductDetail/Vishay-BC-Components/NTCS0805E3103FMT?qs=%2FWiulJ9oly6N%2FcschAk0gQ%3D%3D
USB connector female | 1.88 € | 1 | 1.88 € | https://www.mouser.de/ProductDetail/Molex/67643-3910?qs=x6EjVpvqMVPR04zsu4B0aw%3D%3D
LED blue | 0.18 € | 16 | 2.82 € | https://www.mouser.de/ProductDetail/Wurth-Elektronik/150080BS75000?qs=2kOmHSv6VfT2tBo3UPVqAQ%3D%3D
Kaltgeraete Stecker | 18.39 € | 1 | 18.39 € | https://de.rs-online.com/web/p/iec-steckverbinder/3521825
ESD protection for LEDs | 0.26 € | 16 | 4.21 € | https://www.mouser.de/ProductDetail/Vishay-Semiconductors/VESD16A2-03G-G3-08?qs=UkDUCjYnTB34zpOHUpj7rA%3D%3D
 |  |  | 0.00 €
 |  |  | 0.00 €
 |  |  | 0.00 €
 |  |  | 0.00 €
 |  |  | 0.00 €
 |  |  | 0.00 €
 |  |  | 1,044.14 €
