letrend/UVen/hardware/MTSM340UV2-F5120S-current-driver/MTSM340UV2-F5120S-current-driver.step

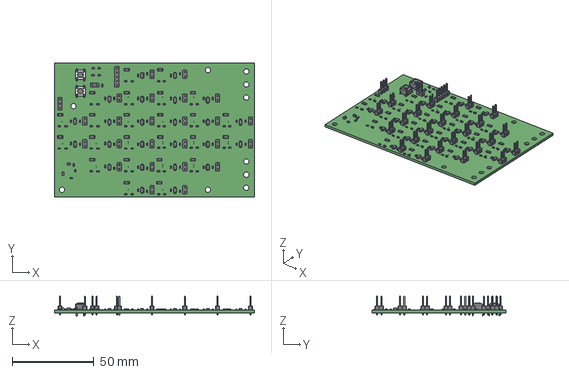
[picture p105: CAD file, 2022-01-01]
hardware/MTSM340UV2-F5120S-current-driver/MTSM340UV2-F5120S-current-driver.step
122.0 x 81.5 x 12.0 mm
