letrend/UVen/hardware/uven2-sbm-120-uv-copper-base-16-leds/uven2-sbm-120-uv-copper-base-16-leds.step

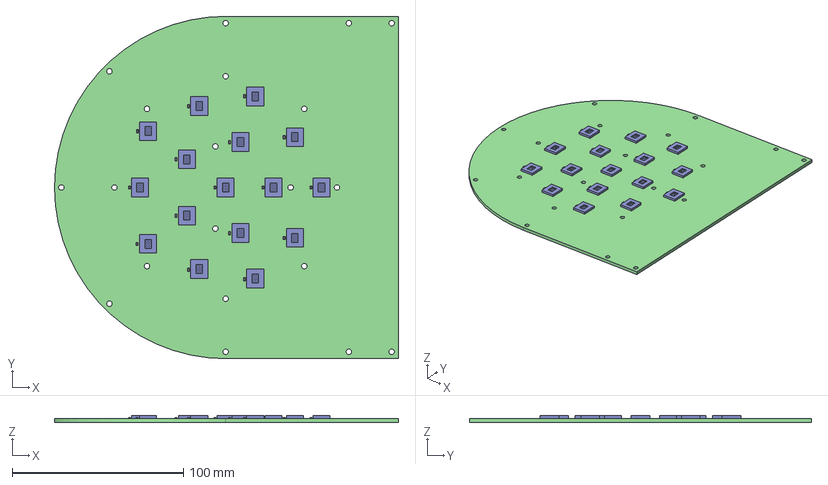
[picture p106: CAD file, 2023-08-11]
hardware/uven2-sbm-120-uv-copper-base-16-leds/uven2-sbm-120-uv-copper-base-16-leds.step
201.0 x 200.0 x 3.88 mm
uven2-sbm-120-uv-copper-base-16-leds PCB
