letrend/UVen/hardware/uven2-mk2-mainboard/uven2-mk2-mainboard.kicad_pcb

## KiCad design hardware/uven2-mk2-mainboard/uven2-mk2-mainboard.kicad_pcb (2024-04-27)

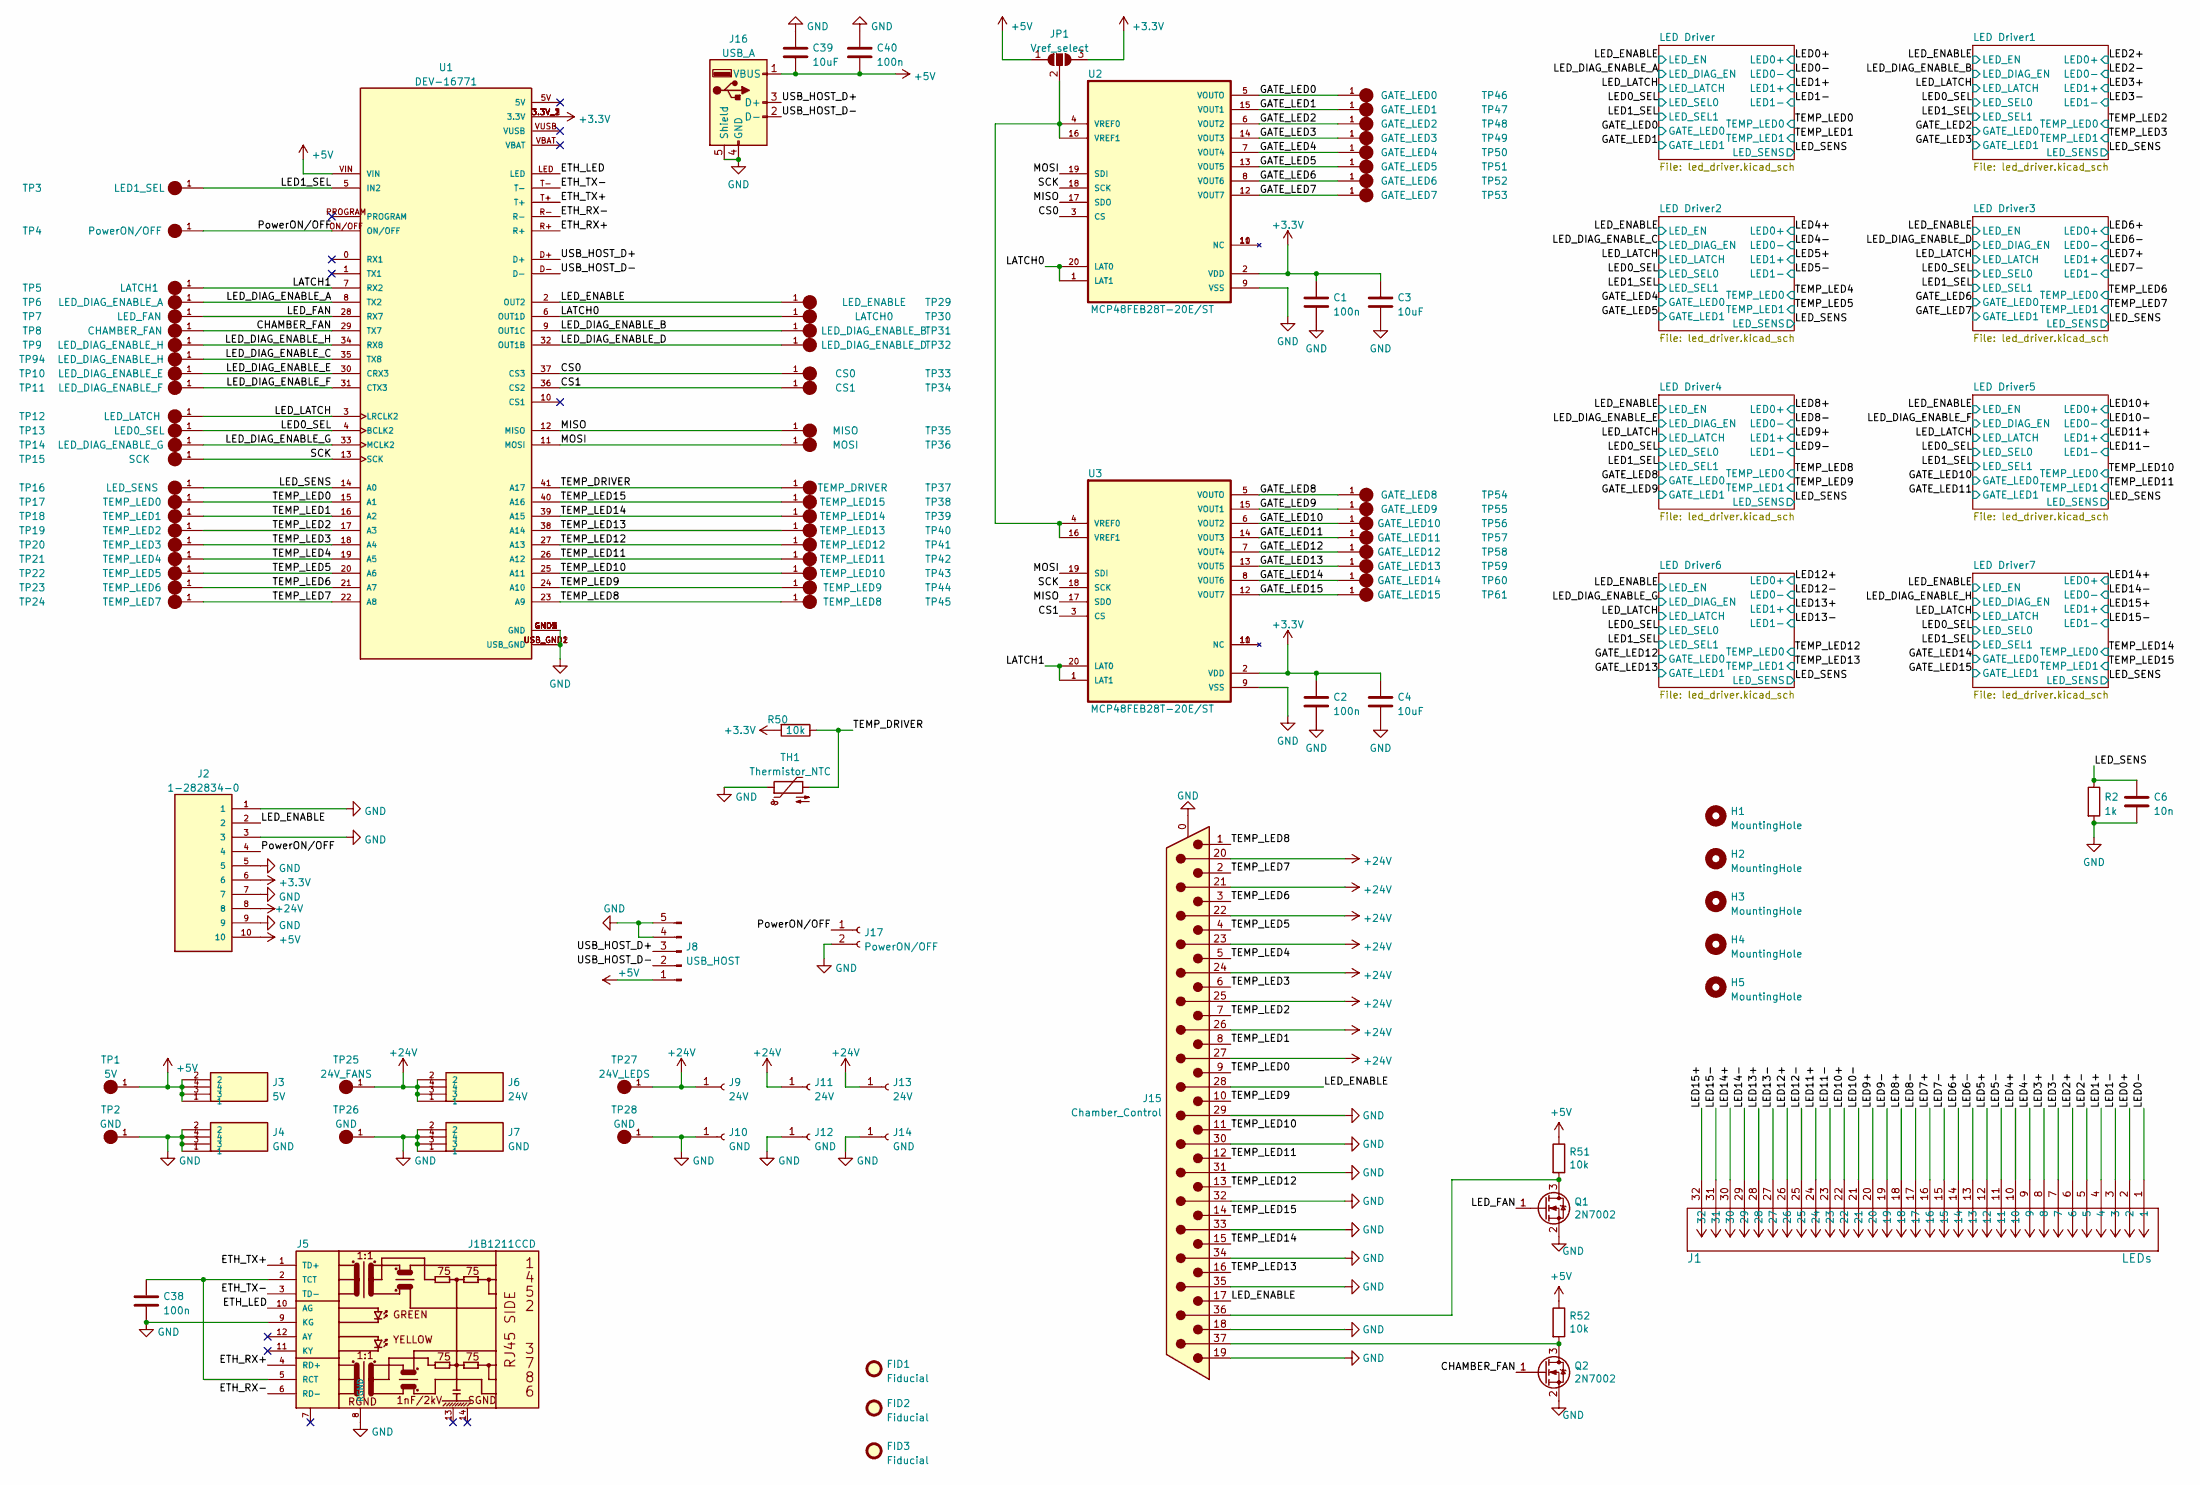
[picture p117: schematic uven2-mk2-mainboard.kicad_sch]

Parts:
C1, C2, C38, C40: 100n; C_0603_1608Metric_Pad1.08x0.95mm_HandSolder
C3, C4, C39: 10uF; C_0603_1608Metric_Pad1.08x0.95mm_HandSolder
C6: 10n; C_0603_1608Metric_Pad1.08x0.95mm_HandSolder
FID1, FID2, FID3: Fiducial; Fiducial_1mm_Dia_2.54mm_Outer_CopperTop
H1, H2, H3, H4, H5: MountingHole; MountingHole_3.2mm_M3
J1: LEDs; CONN_713-1436&slash_037-000_WAG
J2: 1-282834-0; TE_1-282834-0
J3: 5V; KEYSTONE_7767; PARTREV B
J4, J7: GND; KEYSTONE_7767; PARTREV B
J5: J1B1211CCD
J6: 24V; KEYSTONE_7767; PARTREV B
J8: USB_HOST; PinHeader_1x05_P2.54mm_Vertical
J9, J11, J13: 24V; 7466205R
J10, J12, J14: GND; 7466205R
J15: Chamber_Control; DSUB-37_Female_Horizontal_P2.77x2.84mm_EdgePinOffset7.70mm_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
J16: USB_A; USB_A_Molex_67643_Horizontal
J17: PowerON/OFF; PinHeader_1x02_P2.54mm_Vertical
JP1: Vref_select; SolderJumper-3_P1.3mm_Open_RoundedPad1.0x1.5mm_NumberLabels
Q1, Q2: 2N7002; SOT-23
R2: 1k; R_0603_1608Metric_Pad0.98x0.95mm_HandSolder
R50, R51, R52: 10k; R_0603_1608Metric_Pad0.98x0.95mm_HandSolder
TH1: Thermistor_NTC; R_0805_2012Metric_Pad1.20x1.40mm_HandSolder
TP1: 5V; TP420X150; PARTREV 1/06/14
TP2, TP26, TP28: GND; TP420X150; PARTREV 1/06/14
TP3: LED1_SEL; TP420X150; PARTREV 1/06/14
TP4: PowerON/OFF; TP420X150; PARTREV 1/06/14
TP5: LATCH1; TP420X150; PARTREV 1/06/14
TP6: LED_DIAG_ENABLE_A; TP420X150; PARTREV 1/06/14
TP7: LED_FAN; TP420X150; PARTREV 1/06/14
TP8: CHAMBER_FAN; TP420X150; PARTREV 1/06/14
TP9, TP94: LED_DIAG_ENABLE_H; TP420X150; PARTREV 1/06/14
TP10: LED_DIAG_ENABLE_E; TP420X150; PARTREV 1/06/14
TP11: LED_DIAG_ENABLE_F; TP420X150; PARTREV 1/06/14
TP12: LED_LATCH; TP420X150; PARTREV 1/06/14
TP13: LED0_SEL; TP420X150; PARTREV 1/06/14
TP14: LED_DIAG_ENABLE_G; TP420X150; PARTREV 1/06/14
TP15: SCK; TP420X150; PARTREV 1/06/14
TP16: LED_SENS; TP420X150; PARTREV 1/06/14
TP17: TEMP_LED0; TP420X150; PARTREV 1/06/14
TP18: TEMP_LED1; TP420X150; PARTREV 1/06/14
TP19: TEMP_LED2; TP420X150; PARTREV 1/06/14
TP20: TEMP_LED3; TP420X150; PARTREV 1/06/14
TP21: TEMP_LED4; TP420X150; PARTREV 1/06/14
TP22: TEMP_LED5; TP420X150; PARTREV 1/06/14
TP23: TEMP_LED6; TP420X150; PARTREV 1/06/14
TP24: TEMP_LED7; TP420X150; PARTREV 1/06/14
TP25: 24V_FANS; TP420X150; PARTREV 1/06/14
TP27: 24V_LEDS; TP420X150; PARTREV 1/06/14
TP29: LED_ENABLE; TP420X150; PARTREV 1/06/14
TP30: LATCH0; TP420X150; PARTREV 1/06/14
TP31: LED_DIAG_ENABLE_B; TP420X150; PARTREV 1/06/14
TP32: LED_DIAG_ENABLE_D; TP420X150; PARTREV 1/06/14
TP33: CS0; TP420X150; PARTREV 1/06/14
TP34: CS1; TP420X150; PARTREV 1/06/14
TP35: MISO; TP420X150; PARTREV 1/06/14
TP36: MOSI; TP420X150; PARTREV 1/06/14
TP37: TEMP_DRIVER; TP420X150; PARTREV 1/06/14
TP38: TEMP_LED15; TP420X150; PARTREV 1/06/14
TP39: TEMP_LED14; TP420X150; PARTREV 1/06/14
TP40: TEMP_LED13; TP420X150; PARTREV 1/06/14
TP41: TEMP_LED12; TP420X150; PARTREV 1/06/14
TP42: TEMP_LED11; TP420X150; PARTREV 1/06/14
TP43: TEMP_LED10; TP420X150; PARTREV 1/06/14
TP44: TEMP_LED9; TP420X150; PARTREV 1/06/14
TP45: TEMP_LED8; TP420X150; PARTREV 1/06/14
TP46: GATE_LED0; TP420X150; PARTREV 1/06/14
TP47: GATE_LED1; TP420X150; PARTREV 1/06/14
TP48: GATE_LED2; TP420X150; PARTREV 1/06/14
TP49: GATE_LED3; TP420X150; PARTREV 1/06/14
TP50: GATE_LED4; TP420X150; PARTREV 1/06/14
TP51: GATE_LED5; TP420X150; PARTREV 1/06/14
TP52: GATE_LED6; TP420X150; PARTREV 1/06/14
TP53: GATE_LED7; TP420X150; PARTREV 1/06/14
TP54: GATE_LED8; TP420X150; PARTREV 1/06/14
TP55: GATE_LED9; TP420X150; PARTREV 1/06/14
TP56: GATE_LED10; TP420X150; PARTREV 1/06/14
TP57: GATE_LED11; TP420X150; PARTREV 1/06/14
TP58: GATE_LED12; TP420X150; PARTREV 1/06/14
TP59: GATE_LED13; TP420X150; PARTREV 1/06/14
TP60: GATE_LED14; TP420X150; PARTREV 1/06/14
TP61: GATE_LED15; TP420X150; PARTREV 1/06/14
U1: DEV-16771; MODULE_DEV-16771; PARTREV 4.1
U2, U3: MCP48FEB28T-20E/ST; SOP65P640X120-20N

Connections:
+3.3V: C1.1, C2.1, C3.1, C4.1, J2.6, JP1.3 (B), R50.2, U1.3.3V_1 (3.3V), U1.3.3V_2 (3.3V), U1.3.3V_3 (3.3V), U2.2 (VDD), U3.2 (VDD); also elsewhere on the board
+5V: C39.2, C40.2, J2.10, J3.1, J3.2, J3.3, J3.4, J8.1, J16.1 (VBUS), JP1.1 (A), R51.1, R52.1, TP1.1, U1.VIN
+24V: J2.8, J6.1, J6.2, J6.3, J6.4, J9.1, J11.1, J13.1, J15.20, J15.21, J15.22, J15.23, J15.24, J15.25, J15.26, J15.27, TP25.1, TP27.1; also elsewhere on the board
/CHAMBER_FAN: Q2.1 (G), TP8.1, U1.29 (TX7)
/CS0: TP33.1, U1.37 (CS3), U2.3 (CS)
/CS1: TP34.1, U1.36 (CS2), U3.3 (CS)
/ETH_LED: J5.10 (AG), U1.LED
/ETH_RX+: J5.4 (RD+), U1.R+
/ETH_RX-: J5.6 (RD-), U1.R-
/ETH_TX+: J5.1 (TD+), U1.T+
/ETH_TX-: J5.3 (TD-), U1.T-
/GATE_LED0: TP46.1, U2.5 (VOUTO); also elsewhere on the board
/GATE_LED1: TP47.1, U2.15 (VOUT1); also elsewhere on the board
/GATE_LED2: TP48.1, U2.6 (VOUT2); also elsewhere on the board
/GATE_LED3: TP49.1, U2.14 (VOUT3); also elsewhere on the board
/GATE_LED4: TP50.1, U2.7 (VOUT4); also elsewhere on the board
/GATE_LED5: TP51.1, U2.13 (VOUT5); also elsewhere on the board
/GATE_LED6: TP52.1, U2.8 (VOUT6); also elsewhere on the board
/GATE_LED7: TP53.1, U2.12 (VOUT7); also elsewhere on the board
/GATE_LED8: TP54.1, U3.5 (VOUTO); also elsewhere on the board
/GATE_LED9: TP55.1, U3.15 (VOUT1); also elsewhere on the board
/GATE_LED10: TP56.1, U3.6 (VOUT2); also elsewhere on the board
/GATE_LED11: TP57.1, U3.14 (VOUT3); also elsewhere on the board
/GATE_LED12: TP58.1, U3.7 (VOUT4); also elsewhere on the board
/GATE_LED13: TP59.1, U3.13 (VOUT5); also elsewhere on the board
/GATE_LED14: TP60.1, U3.8 (VOUT6); also elsewhere on the board
/GATE_LED15: TP61.1, U3.12 (VOUT7); also elsewhere on the board
/LATCH0: TP30.1, U1.6 (OUT1D), U2.1 (LAT1), U2.20 (LAT0)
/LATCH1: TP5.1, U1.7 (RX2), U3.1 (LAT1), U3.20 (LAT0)
/LED0+: J1.2; also elsewhere on the board
/LED0-: J1.1; also elsewhere on the board
/LED0_SEL: TP13.1, U1.4 (BCLK2); also elsewhere on the board
/LED1+: J1.4; also elsewhere on the board
/LED1-: J1.3; also elsewhere on the board
/LED1_SEL: TP3.1, U1.5 (IN2); also elsewhere on the board
/LED2+: J1.6; also elsewhere on the board
/LED2-: J1.5; also elsewhere on the board
/LED3+: J1.8; also elsewhere on the board
/LED3-: J1.7; also elsewhere on the board
/LED4+: J1.10; also elsewhere on the board
/LED4-: J1.9; also elsewhere on the board
/LED5+: J1.12; also elsewhere on the board
/LED5-: J1.11; also elsewhere on the board
/LED6+: J1.14; also elsewhere on the board
/LED6-: J1.13; also elsewhere on the board
/LED7+: J1.16; also elsewhere on the board
/LED7-: J1.15; also elsewhere on the board
/LED8+: J1.18; also elsewhere on the board
/LED8-: J1.17; also elsewhere on the board
/LED9+: J1.20; also elsewhere on the board
/LED9-: J1.19; also elsewhere on the board
/LED10+: J1.22; also elsewhere on the board
/LED10-: J1.21; also elsewhere on the board
/LED11+: J1.24; also elsewhere on the board
/LED11-: J1.23; also elsewhere on the board
/LED12+: J1.26; also elsewhere on the board
/LED12-: J1.25; also elsewhere on the board
/LED13+: J1.28; also elsewhere on the board
/LED13-: J1.27; also elsewhere on the board
/LED14+: J1.30; also elsewhere on the board
/LED14-: J1.29; also elsewhere on the board
/LED15+: J1.32; also elsewhere on the board
/LED15-: J1.31; also elsewhere on the board
/LED_DIAG_ENABLE_A: TP6.1, U1.8 (TX2); also elsewhere on the board
/LED_DIAG_ENABLE_B: TP31.1, U1.9 (OUT1C); also elsewhere on the board
/LED_DIAG_ENABLE_C: TP94.1, U1.35 (TX8); also elsewhere on the board
/LED_DIAG_ENABLE_D: TP32.1, U1.32 (OUT1B); also elsewhere on the board
/LED_DIAG_ENABLE_E: TP10.1, U1.30 (CRX3); also elsewhere on the board
/LED_DIAG_ENABLE_F: TP11.1, U1.31 (CTX3); also elsewhere on the board
/LED_DIAG_ENABLE_G: TP14.1, U1.33 (MCLK2); also elsewhere on the board
/LED_DIAG_ENABLE_H: TP9.1, U1.34 (RX8); also elsewhere on the board
/LED_ENABLE: J2.2, J15.17, J15.28, TP29.1, U1.2 (OUT2); also elsewhere on the board
/LED_FAN: Q1.1 (G), TP7.1, U1.28 (RX7)
/LED_LATCH: TP12.1, U1.3 (LRCLK2); also elsewhere on the board
/LED_SENS: C6.1, R2.1, TP16.1, U1.14 (A0); also elsewhere on the board
/MISO: TP35.1, U1.12 (MISO), U2.17 (SDO), U3.17 (SDO)
/MOSI: TP36.1, U1.11 (MOSI), U2.19 (SDI), U3.19 (SDI)
/PowerON/OFF: J2.4, J17.1, TP4.1, U1.ON/OFF
/SCK: TP15.1, U1.13 (SCK), U2.18 (SCK), U3.18 (SCK)
/TEMP_DRIVER: R50.1, TH1.2, TP37.1, U1.41 (A17)
/TEMP_LED0: J15.9, TP17.1, U1.15 (A1); also elsewhere on the board
/TEMP_LED1: J15.8, TP18.1, U1.16 (A2); also elsewhere on the board
/TEMP_LED2: J15.7, TP19.1, U1.17 (A3); also elsewhere on the board
/TEMP_LED3: J15.6, TP20.1, U1.18 (A4); also elsewhere on the board
/TEMP_LED4: J15.5, TP21.1, U1.19 (A5); also elsewhere on the board
/TEMP_LED5: J15.4, TP22.1, U1.20 (A6); also elsewhere on the board
/TEMP_LED6: J15.3, TP23.1, U1.21 (A7); also elsewhere on the board
/TEMP_LED7: J15.2, TP24.1, U1.22 (A8); also elsewhere on the board
/TEMP_LED8: J15.1, TP45.1, U1.23 (A9); also elsewhere on the board
/TEMP_LED9: J15.10, TP44.1, U1.24 (A10); also elsewhere on the board
/TEMP_LED10: J15.11, TP43.1, U1.25 (A11); also elsewhere on the board
/TEMP_LED11: J15.12, TP42.1, U1.26 (A12); also elsewhere on the board
/TEMP_LED12: J15.13, TP41.1, U1.27 (A13); also elsewhere on the board
/TEMP_LED13: J15.16, TP40.1, U1.38 (A14); also elsewhere on the board
/TEMP_LED14: J15.15, TP39.1, U1.39 (A15); also elsewhere on the board
/TEMP_LED15: J15.14, TP38.1, U1.40 (A16); also elsewhere on the board
/USB_HOST_D+: J8.3, J16.3 (D+), U1.D+
/USB_HOST_D-: J8.2, J16.2 (D-), U1.D-
GND: C1.2, C2.2, C3.2, C4.2, C6.2, C38.2, C39.1, C40.1, J2.1, J2.3, J2.5, J2.7, J2.9, J4.1, J4.2, J4.3, J4.4, J5.8 (RGND), J5.9 (KG), J7.1, J7.2, J7.3, J7.4, J8.4, J8.5, J10.1, J12.1, J14.1, J15.0 (PAD), J15.18, J15.19, J15.29, J15.30, J15.31, J15.32, J15.33, J15.34, J15.35, J16.4 (GND), J16.5 (Shield), J17.2, Q1.2 (S), Q2.2 (S), R2.2, TH1.1, TP2.1, TP26.1, TP28.1, U1.GND1 (GND), U1.GND2 (GND), U1.GND3 (GND), U1.GND4 (GND), U1.GND5 (GND), U1.USB_GND1 (USB_GND), U1.USB_GND2 (USB_GND), U2.9 (VSS), U3.9 (VSS); also elsewhere on the board
unnamed: C38.1, J5.2 (TCT), J5.5 (RCT)
unnamed: JP1.2 (C), U2.4 (VREF0), U2.16 (VREF1), U3.4 (VREF0), U3.16 (VREF1)
unnamed: J15.36, Q1.3 (D), R51.2
unnamed: J15.37, Q2.3 (D), R52.2

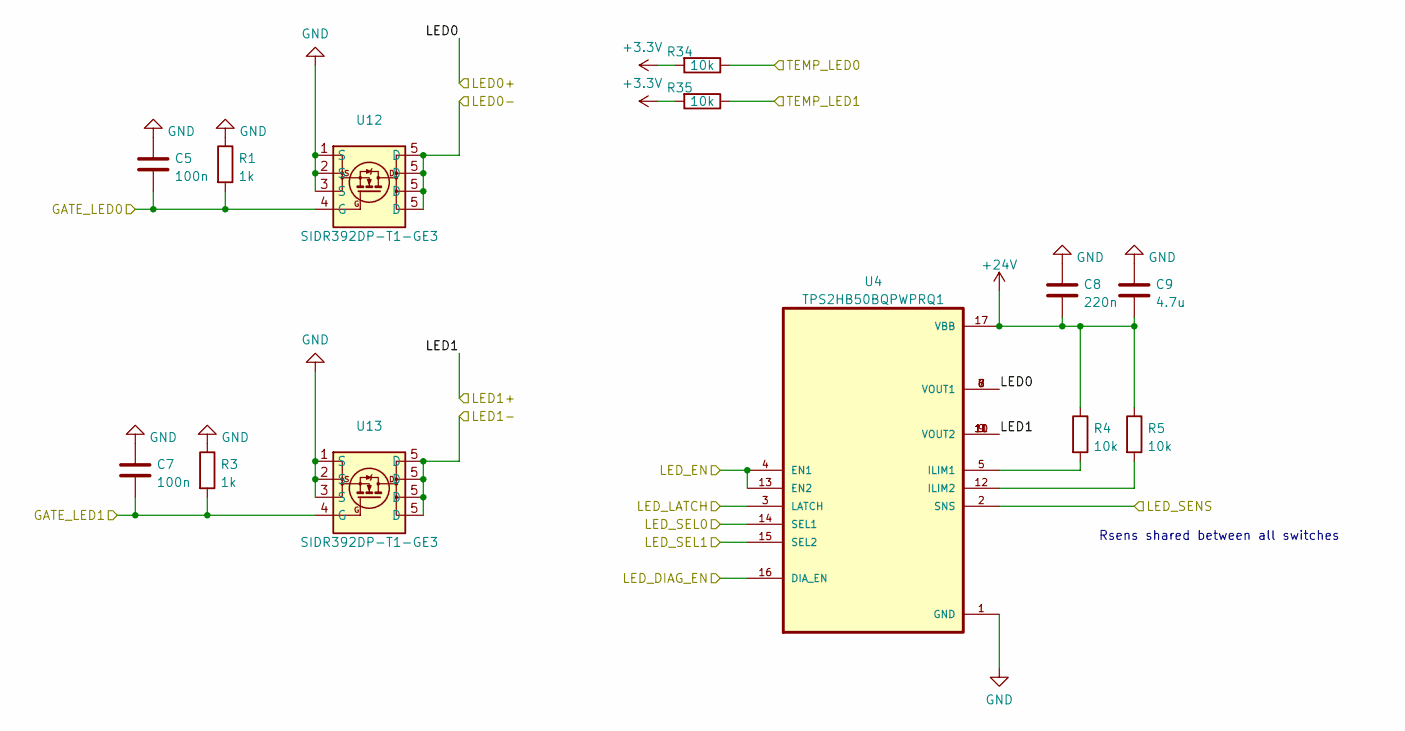
[picture p118: schematic led_driver.kicad_sch]

Parts:
C5, C7: 100n; C_0603_1608Metric_Pad1.08x0.95mm_HandSolder
C8: 220n; C_0603_1608Metric_Pad1.08x0.95mm_HandSolder
C9: 4.7u; C_0603_1608Metric_Pad1.08x0.95mm_HandSolder
R1, R3: 1k; R_0603_1608Metric_Pad0.98x0.95mm_HandSolder
R4, R5, R34, R35: 10k; R_0603_1608Metric_Pad0.98x0.95mm_HandSolder
U4: TPS2HB50BQPWPRQ1; SOP65P640X120-17N
U12, U13: SIDR392DP-T1-GE3; PowerPAK SO-8DC

Connections:
+3.3V: R34.2, R35.2; also elsewhere on the board
+24V: C8.2, C9.2, R4.1, R5.1, U4.17 (VBB); also elsewhere on the board
/GATE_LED0: C5.2, R1.2, U12.4 (G); also elsewhere on the board
/GATE_LED1: C7.2, R3.2, U13.4 (G); also elsewhere on the board
/LED0+: U4.6 (VOUT1), U4.7 (VOUT1), U4.8 (VOUT1); also elsewhere on the board
/LED0-: U12.5 (D); also elsewhere on the board
/LED0_SEL: U4.14 (SEL1); also elsewhere on the board
/LED1+: U4.9 (VOUT2), U4.10 (VOUT2), U4.11 (VOUT2); also elsewhere on the board
/LED1-: U13.5 (D); also elsewhere on the board
/LED1_SEL: U4.15 (SEL2); also elsewhere on the board
/LED_DIAG_ENABLE_A: U4.16 (DIA_EN); also elsewhere on the board
/LED_ENABLE: U4.4 (EN1), U4.13 (EN2); also elsewhere on the board
/LED_LATCH: U4.3 (LATCH); also elsewhere on the board
/LED_SENS: U4.2 (SNS); also elsewhere on the board
/TEMP_LED0: R34.1; also elsewhere on the board
/TEMP_LED1: R35.1; also elsewhere on the board
GND: C5.1, C7.1, C8.1, C9.1, R1.1, R3.1, U4.1 (GND), U12.1 (S), U12.2 (S), U12.3 (S), U13.1 (S), U13.2 (S), U13.3 (S); also elsewhere on the board
unnamed: R4.2, U4.5 (ILIM1)
unnamed: R5.2, U4.12 (ILIM2)

Parts of its further copies:
C10, C11, C14, C15, C18, C19, C22, C23, C26, C27, C30, C31, C34, C35: 100n; C_0603_1608Metric_Pad1.08x0.95mm_HandSolder
C12, C16, C20, C24, C28, C32, C36: 220n; C_0603_1608Metric_Pad1.08x0.95mm_HandSolder
C13, C17, C21, C25, C29, C33, C37: 4.7u; C_0603_1608Metric_Pad1.08x0.95mm_HandSolder
R6, R7, R10, R11, R14, R15, R18, R19, R22, R23, R26, R27, R30, R31: 1k; R_0603_1608Metric_Pad0.98x0.95mm_HandSolder
R8, R9, R12, R13, R16, R17, R20, R21, R24, R25, R28, R29, R32, R33, R36, R37, R38, R39, R40, R41, R42, R43, R44, R45, R46, R47, R48, R49: 10k; R_0603_1608Metric_Pad0.98x0.95mm_HandSolder
U5, U6, U7, U8, U9, U10, U11: TPS2HB50BQPWPRQ1; SOP65P640X120-17N
U14, U15, U16, U17, U18, U19, U20, U21, U22, U23, U24, U25, U26, U27: SIDR392DP-T1-GE3; PowerPAK SO-8DC

Connections of its further copies:
+3.3V: R36.2, R37.2, R38.2, R39.2, R40.2, R41.2, R42.2, R43.2, R44.2, R45.2, R46.2, R47.2, R48.2, R49.2; also elsewhere on the board
+24V: C12.2, C13.2, C16.2, C17.2, C20.2, C21.2, C24.2, C25.2, C28.2, C29.2, C32.2, C33.2, C36.2, C37.2, R8.1, R9.1, R12.1, R13.1, R16.1, R17.1, R20.1, R21.1, R24.1, R25.1, R28.1, R29.1, R32.1, R33.1, U5.17 (VBB), U6.17 (VBB), U7.17 (VBB), U8.17 (VBB), U9.17 (VBB), U10.17 (VBB), U11.17 (VBB); also elsewhere on the board
/GATE_LED2: C10.2, R6.2, U14.4 (G); also elsewhere on the board
/GATE_LED3: C11.2, R7.2, U15.4 (G); also elsewhere on the board
/GATE_LED4: C14.2, R10.2, U16.4 (G); also elsewhere on the board
/GATE_LED5: C15.2, R11.2, U17.4 (G); also elsewhere on the board
/GATE_LED6: C18.2, R14.2, U18.4 (G); also elsewhere on the board
/GATE_LED7: C19.2, R15.2, U19.4 (G); also elsewhere on the board
/GATE_LED8: C22.2, R18.2, U20.4 (G); also elsewhere on the board
/GATE_LED9: C23.2, R19.2, U21.4 (G); also elsewhere on the board
/GATE_LED10: C26.2, R22.2, U22.4 (G); also elsewhere on the board
/GATE_LED11: C27.2, R23.2, U23.4 (G); also elsewhere on the board
/GATE_LED12: C30.2, R26.2, U24.4 (G); also elsewhere on the board
/GATE_LED13: C31.2, R27.2, U25.4 (G); also elsewhere on the board
/GATE_LED14: C34.2, R30.2, U26.4 (G); also elsewhere on the board
/GATE_LED15: C35.2, R31.2, U27.4 (G); also elsewhere on the board
/LED0_SEL: U5.14 (SEL1), U6.14 (SEL1), U7.14 (SEL1), U8.14 (SEL1), U9.14 (SEL1), U10.14 (SEL1), U11.14 (SEL1); also elsewhere on the board
/LED1_SEL: U5.15 (SEL2), U6.15 (SEL2), U7.15 (SEL2), U8.15 (SEL2), U9.15 (SEL2), U10.15 (SEL2), U11.15 (SEL2); also elsewhere on the board
/LED2+: U5.6 (VOUT1), U5.7 (VOUT1), U5.8 (VOUT1); also elsewhere on the board
/LED2-: U14.5 (D); also elsewhere on the board
/LED3+: U5.9 (VOUT2), U5.10 (VOUT2), U5.11 (VOUT2); also elsewhere on the board
/LED3-: U15.5 (D); also elsewhere on the board
/LED4+: U6.6 (VOUT1), U6.7 (VOUT1), U6.8 (VOUT1); also elsewhere on the board
/LED4-: U16.5 (D); also elsewhere on the board
/LED5+: U6.9 (VOUT2), U6.10 (VOUT2), U6.11 (VOUT2); also elsewhere on the board
/LED5-: U17.5 (D); also elsewhere on the board
/LED6+: U7.6 (VOUT1), U7.7 (VOUT1), U7.8 (VOUT1); also elsewhere on the board
/LED6-: U18.5 (D); also elsewhere on the board
/LED7+: U7.9 (VOUT2), U7.10 (VOUT2), U7.11 (VOUT2); also elsewhere on the board
/LED7-: U19.5 (D); also elsewhere on the board
/LED8+: U8.6 (VOUT1), U8.7 (VOUT1), U8.8 (VOUT1); also elsewhere on the board
/LED8-: U20.5 (D); also elsewhere on the board
/LED9+: U8.9 (VOUT2), U8.10 (VOUT2), U8.11 (VOUT2); also elsewhere on the board
/LED9-: U21.5 (D); also elsewhere on the board
/LED10+: U9.6 (VOUT1), U9.7 (VOUT1), U9.8 (VOUT1); also elsewhere on the board
/LED10-: U22.5 (D); also elsewhere on the board
/LED11+: U9.9 (VOUT2), U9.10 (VOUT2), U9.11 (VOUT2); also elsewhere on the board
/LED11-: U23.5 (D); also elsewhere on the board
/LED12+: U10.6 (VOUT1), U10.7 (VOUT1), U10.8 (VOUT1); also elsewhere on the board
/LED12-: U24.5 (D); also elsewhere on the board
/LED13+: U10.9 (VOUT2), U10.10 (VOUT2), U10.11 (VOUT2); also elsewhere on the board
/LED13-: U25.5 (D); also elsewhere on the board
/LED14+: U11.6 (VOUT1), U11.7 (VOUT1), U11.8 (VOUT1); also elsewhere on the board
/LED14-: U26.5 (D); also elsewhere on the board
/LED15+: U11.9 (VOUT2), U11.10 (VOUT2), U11.11 (VOUT2); also elsewhere on the board
/LED15-: U27.5 (D); also elsewhere on the board
/LED_DIAG_ENABLE_B: U5.16 (DIA_EN); also elsewhere on the board
/LED_DIAG_ENABLE_C: U6.16 (DIA_EN); also elsewhere on the board
/LED_DIAG_ENABLE_D: U7.16 (DIA_EN); also elsewhere on the board
/LED_DIAG_ENABLE_E: U8.16 (DIA_EN); also elsewhere on the board
/LED_DIAG_ENABLE_F: U9.16 (DIA_EN); also elsewhere on the board
/LED_DIAG_ENABLE_G: U10.16 (DIA_EN); also elsewhere on the board
/LED_DIAG_ENABLE_H: U11.16 (DIA_EN); also elsewhere on the board
/LED_ENABLE: U5.4 (EN1), U5.13 (EN2), U6.4 (EN1), U6.13 (EN2), U7.4 (EN1), U7.13 (EN2), U8.4 (EN1), U8.13 (EN2), U9.4 (EN1), U9.13 (EN2), U10.4 (EN1), U10.13 (EN2), U11.4 (EN1), U11.13 (EN2); also elsewhere on the board
/LED_LATCH: U5.3 (LATCH), U6.3 (LATCH), U7.3 (LATCH), U8.3 (LATCH), U9.3 (LATCH), U10.3 (LATCH), U11.3 (LATCH); also elsewhere on the board
/LED_SENS: U5.2 (SNS), U6.2 (SNS), U7.2 (SNS), U8.2 (SNS), U9.2 (SNS), U10.2 (SNS), U11.2 (SNS); also elsewhere on the board
/TEMP_LED2: R36.1; also elsewhere on the board
/TEMP_LED3: R37.1; also elsewhere on the board
/TEMP_LED4: R38.1; also elsewhere on the board
/TEMP_LED5: R39.1; also elsewhere on the board
/TEMP_LED6: R40.1; also elsewhere on the board
/TEMP_LED7: R41.1; also elsewhere on the board
/TEMP_LED8: R42.1; also elsewhere on the board
/TEMP_LED9: R43.1; also elsewhere on the board
/TEMP_LED10: R44.1; also elsewhere on the board
/TEMP_LED11: R45.1; also elsewhere on the board
/TEMP_LED12: R46.1; also elsewhere on the board
/TEMP_LED13: R47.1; also elsewhere on the board
/TEMP_LED14: R48.1; also elsewhere on the board
/TEMP_LED15: R49.1; also elsewhere on the board
GND: C10.1, C11.1, C12.1, C13.1, C14.1, C15.1, C16.1, C17.1, C18.1, C19.1, C20.1, C21.1, C22.1, C23.1, C24.1, C25.1, C26.1, C27.1, C28.1, C29.1, C30.1, C31.1, C32.1, C33.1, C34.1, C35.1, C36.1, C37.1, R6.1, R7.1, R10.1, R11.1, R14.1, R15.1, R18.1, R19.1, R22.1, R23.1, R26.1, R27.1, R30.1, R31.1, U5.1 (GND), U6.1 (GND), U7.1 (GND), U8.1 (GND), U9.1 (GND), U10.1 (GND), U11.1 (GND), U14.1 (S), U14.2 (S), U14.3 (S), U15.1 (S), U15.2 (S), U15.3 (S), U16.1 (S), U16.2 (S), U16.3 (S), U17.1 (S), U17.2 (S), U17.3 (S), U18.1 (S), U18.2 (S), U18.3 (S), U19.1 (S), U19.2 (S), U19.3 (S), U20.1 (S), U20.2 (S), U20.3 (S), U21.1 (S), U21.2 (S), U21.3 (S), U22.1 (S), U22.2 (S), U22.3 (S), U23.1 (S), U23.2 (S), U23.3 (S), U24.1 (S), U24.2 (S), U24.3 (S), U25.1 (S), U25.2 (S), U25.3 (S), U26.1 (S), U26.2 (S), U26.3 (S), U27.1 (S), U27.2 (S), U27.3 (S); also elsewhere on the board
unnamed: R8.2, U5.5 (ILIM1)
unnamed: R9.2, U5.12 (ILIM2)
unnamed: R12.2, U6.5 (ILIM1)
unnamed: R13.2, U6.12 (ILIM2)
unnamed: R16.2, U7.5 (ILIM1)
unnamed: R17.2, U7.12 (ILIM2)
unnamed: R20.2, U8.5 (ILIM1)
unnamed: R21.2, U8.12 (ILIM2)
unnamed: R24.2, U9.5 (ILIM1)
unnamed: R25.2, U9.12 (ILIM2)
unnamed: R28.2, U10.5 (ILIM1)
unnamed: R29.2, U10.12 (ILIM2)
unnamed: R32.2, U11.5 (ILIM1)
unnamed: R33.2, U11.12 (ILIM2)

Notes on the sheet:
Rsens shared between all switches

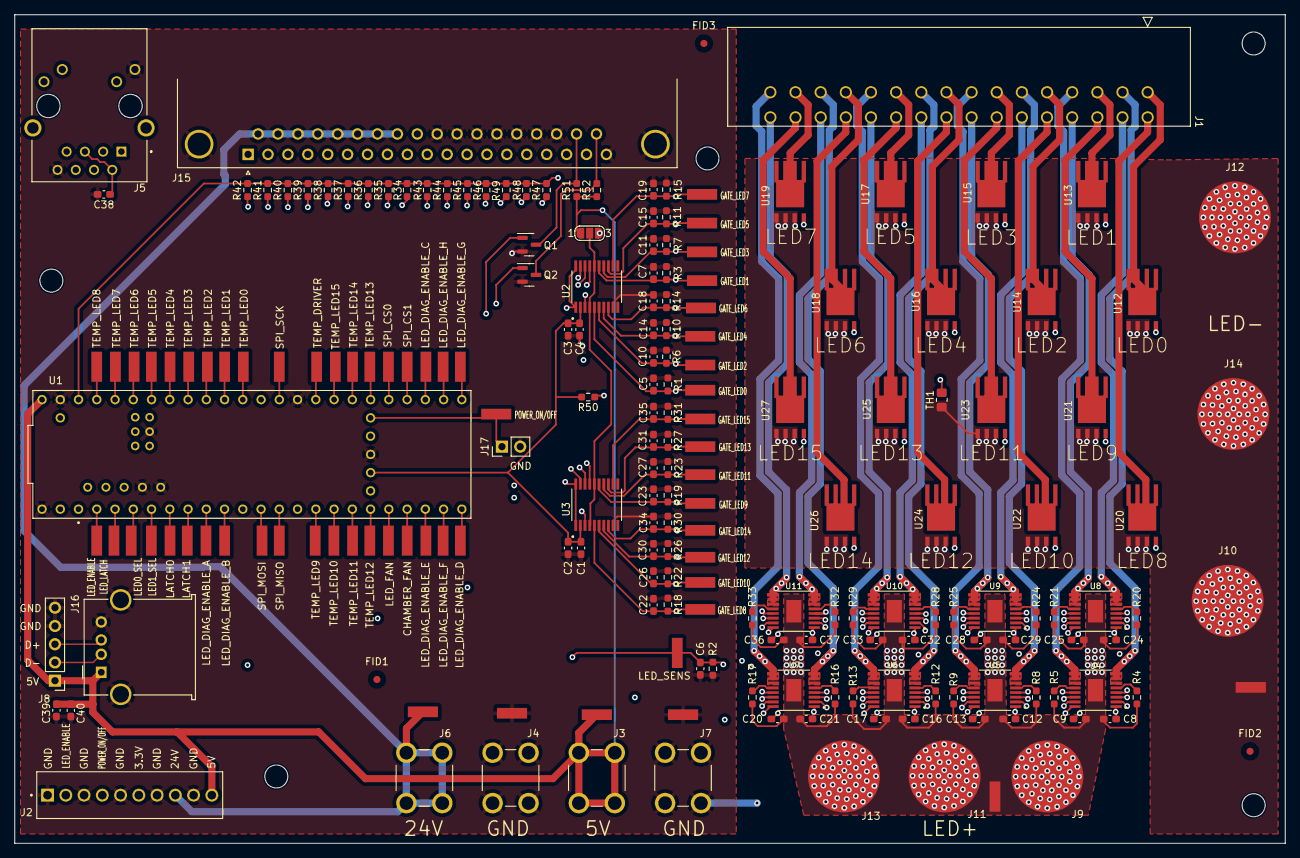
[picture p119: board uven2-mk2-mainboard.kicad_pcb from above]

Board: 4 copper layers, 176.8 x 115.3 mm, 210 parts (0 on the bottom side), 119 nets.
