letrend/UVen/hardware/uven2-sbm-120-uv-copper-base-16-leds/uven2-sbm-120-uv-copper-base-16-leds.kicad_pcb

## KiCad design hardware/uven2-sbm-120-uv-copper-base-16-leds/uven2-sbm-120-uv-copper-base-16-leds.kicad_pcb (2023-07-08)

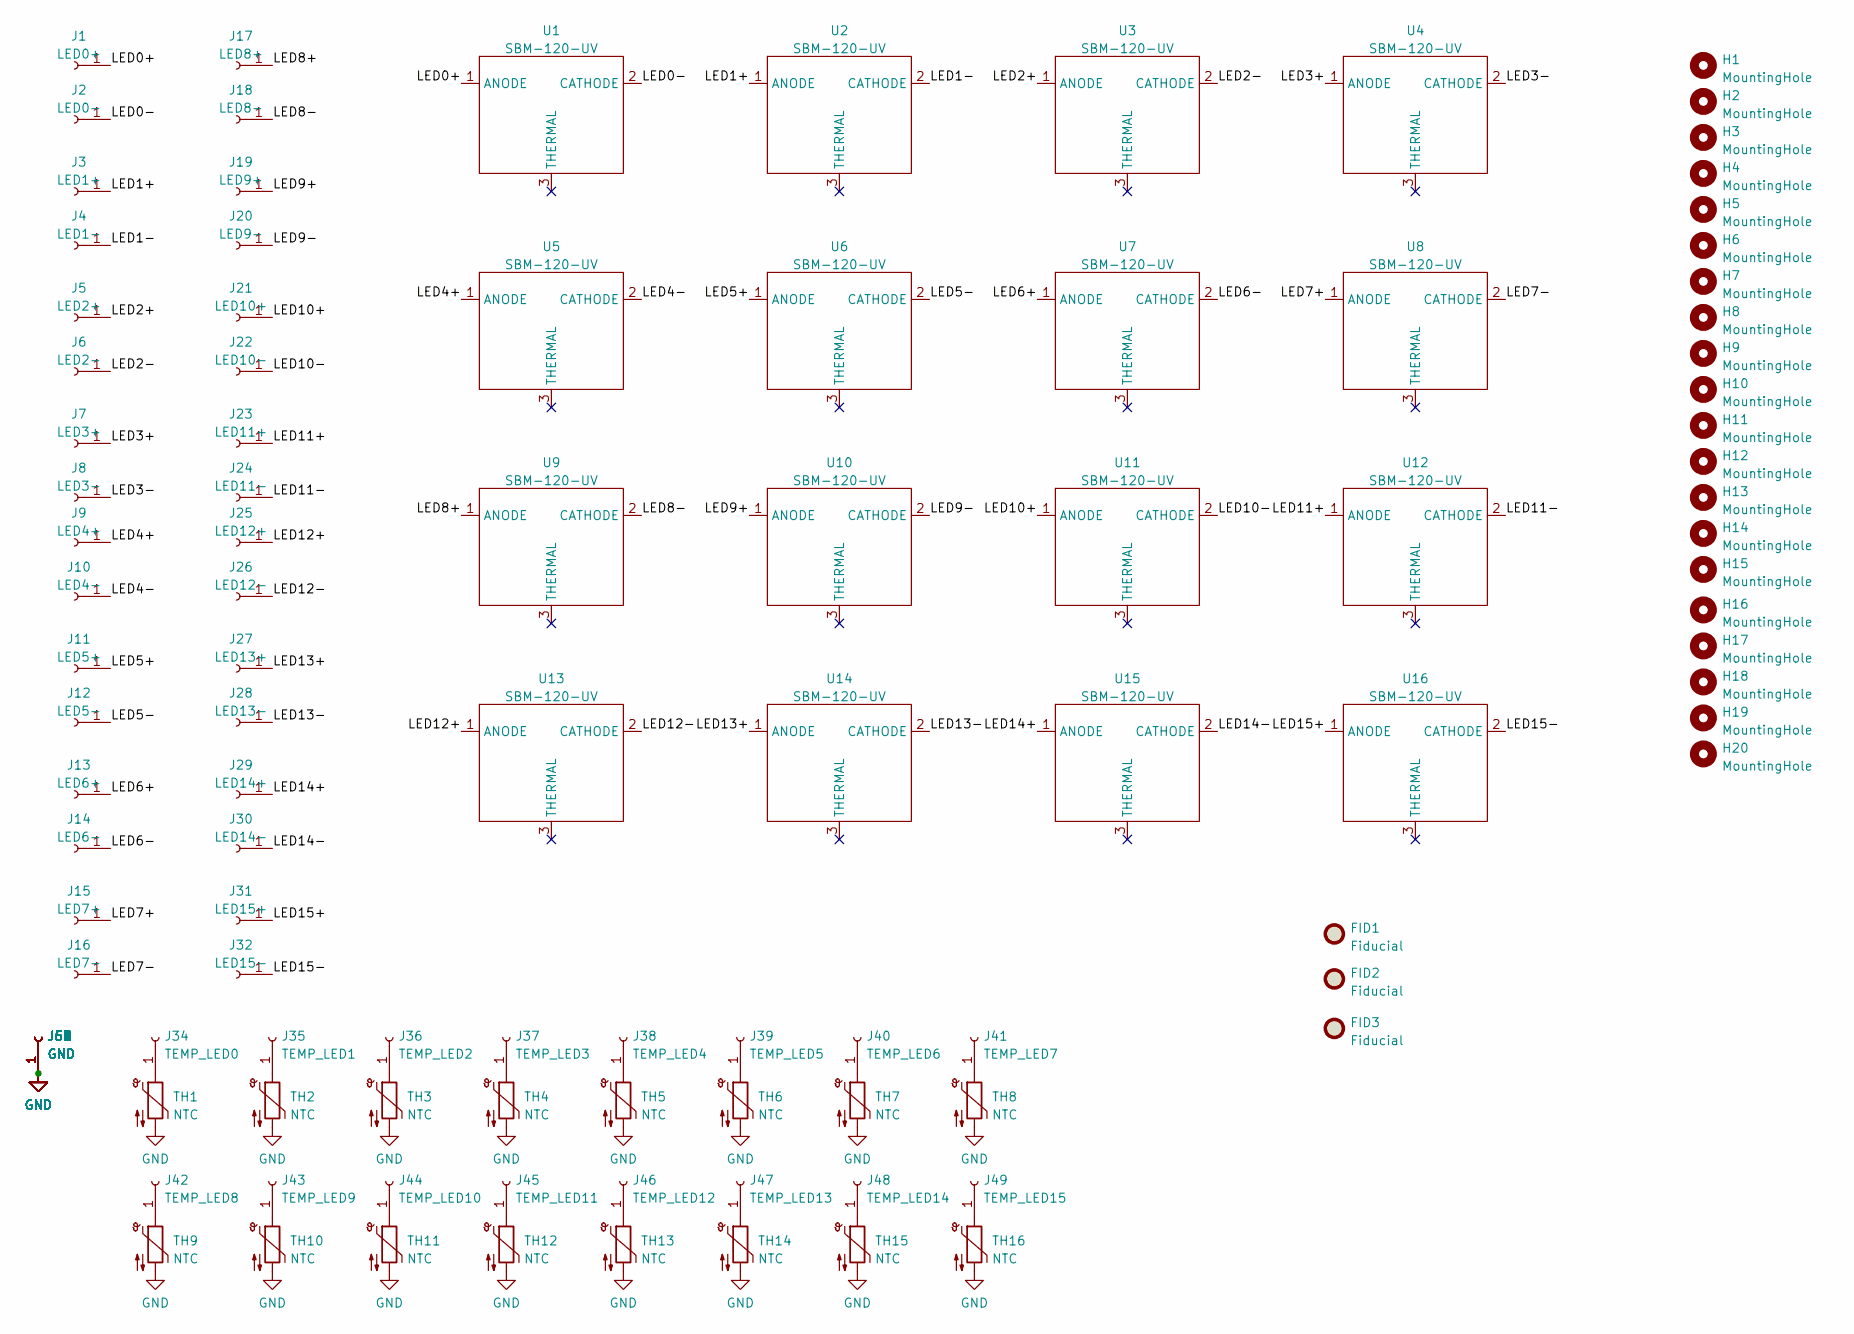
[picture p120: schematic uven2-sbm-120-uv-copper-base-16-leds.kicad_sch]

Parts:
FID1, FID2, FID3: Fiducial; Fiducial_1mm_Dia_2.54mm_Outer_CopperTop
H1, H2, H3, H4, H5, H6, H7, H8, H9, H10, H11, H12, H13, H14, H15, H16, H17, H18, H19, H20: MountingHole; MountingHole_3.2mm_M3
J1: LED0+; TestPoint_Pad_3.0x3.0mm
J2: LED0-; TestPoint_Pad_3.0x3.0mm
J3: LED1+; TestPoint_Pad_3.0x3.0mm
J4: LED1-; TestPoint_Pad_3.0x3.0mm
J5: LED2+; TestPoint_Pad_3.0x3.0mm
J6: LED2-; TestPoint_Pad_3.0x3.0mm
J7: LED3+; TestPoint_Pad_3.0x3.0mm
J8: LED3-; TestPoint_Pad_3.0x3.0mm
J9: LED4+; TestPoint_Pad_3.0x3.0mm
J10: LED4-; TestPoint_Pad_3.0x3.0mm
J11: LED5+; TestPoint_Pad_3.0x3.0mm
J12: LED5-; TestPoint_Pad_3.0x3.0mm
J13: LED6+; TestPoint_Pad_3.0x3.0mm
J14: LED6-; TestPoint_Pad_3.0x3.0mm
J15: LED7+; TestPoint_Pad_3.0x3.0mm
J16: LED7-; TestPoint_Pad_3.0x3.0mm
J17: LED8+; TestPoint_Pad_3.0x3.0mm
J18: LED8-; TestPoint_Pad_3.0x3.0mm
J19: LED9+; TestPoint_Pad_3.0x3.0mm
J20: LED9-; TestPoint_Pad_3.0x3.0mm
J21: LED10+; TestPoint_Pad_3.0x3.0mm
J22: LED10-; TestPoint_Pad_3.0x3.0mm
J23: LED11+; TestPoint_Pad_3.0x3.0mm
J24: LED11-; TestPoint_Pad_3.0x3.0mm
J25: LED12+; TestPoint_Pad_3.0x3.0mm
J26: LED12-; TestPoint_Pad_3.0x3.0mm
J27: LED13+; TestPoint_Pad_3.0x3.0mm
J28: LED13-; TestPoint_Pad_3.0x3.0mm
J29: LED14+; TestPoint_Pad_3.0x3.0mm
J30: LED14-; TestPoint_Pad_3.0x3.0mm
J31: LED15+; TestPoint_Pad_3.0x3.0mm
J32: LED15-; TestPoint_Pad_3.0x3.0mm
J34: TEMP_LED0; TestPoint_Pad_2.0x2.0mm
J35: TEMP_LED1; TestPoint_Pad_2.0x2.0mm
J36: TEMP_LED2; TestPoint_Pad_2.0x2.0mm
J37: TEMP_LED3; TestPoint_Pad_2.0x2.0mm
J38: TEMP_LED4; TestPoint_Pad_2.0x2.0mm
J39: TEMP_LED5; TestPoint_Pad_2.0x2.0mm
J40: TEMP_LED6; TestPoint_Pad_2.0x2.0mm
J41: TEMP_LED7; TestPoint_Pad_2.0x2.0mm
J42: TEMP_LED8; TestPoint_Pad_2.0x2.0mm
J43: TEMP_LED9; TestPoint_Pad_2.0x2.0mm
J44: TEMP_LED10; TestPoint_Pad_2.0x2.0mm
J45: TEMP_LED11; TestPoint_Pad_2.0x2.0mm
J46: TEMP_LED12; TestPoint_Pad_2.0x2.0mm
J47: TEMP_LED13; TestPoint_Pad_2.0x2.0mm
J48: TEMP_LED14; TestPoint_Pad_2.0x2.0mm
J49: TEMP_LED15; TestPoint_Pad_2.0x2.0mm
J50, J51, J52, J53, J54, J55, J56, J57, J58, J59, J60, J61, J62, J63, J64, J65: GND; TestPoint_Pad_2.0x2.0mm
TH1, TH2, TH3, TH4, TH5, TH6, TH7, TH8, TH9, TH10, TH11, TH12, TH13, TH14, TH15, TH16: NTC; R_0805_2012Metric_Pad1.20x1.40mm_HandSolder
U1, U2, U3, U4, U5, U6, U7, U8, U9, U10, U11, U12, U13, U14, U15, U16: SBM-120-UV

Connections:
/LED0+: J1.1, U1.1 (ANODE)
/LED0-: J2.1, U1.2 (CATHODE)
/LED1+: J3.1, U2.1 (ANODE)
/LED1-: J4.1, U2.2 (CATHODE)
/LED2+: J5.1, U3.1 (ANODE)
/LED2-: J6.1, U3.2 (CATHODE)
/LED3+: J7.1, U4.1 (ANODE)
/LED3-: J8.1, U4.2 (CATHODE)
/LED4+: J9.1, U5.1 (ANODE)
/LED4-: J10.1, U5.2 (CATHODE)
/LED5+: J11.1, U6.1 (ANODE)
/LED5-: J12.1, U6.2 (CATHODE)
/LED6+: J13.1, U7.1 (ANODE)
/LED6-: J14.1, U7.2 (CATHODE)
/LED7+: J15.1, U8.1 (ANODE)
/LED7-: J16.1, U8.2 (CATHODE)
/LED8+: J17.1, U9.1 (ANODE)
/LED8-: J18.1, U9.2 (CATHODE)
/LED9+: J19.1, U10.1 (ANODE)
/LED9-: J20.1, U10.2 (CATHODE)
/LED10+: J21.1, U11.1 (ANODE)
/LED10-: J22.1, U11.2 (CATHODE)
/LED11+: J23.1, U12.1 (ANODE)
/LED11-: J24.1, U12.2 (CATHODE)
/LED12+: J25.1, U13.1 (ANODE)
/LED12-: J26.1, U13.2 (CATHODE)
/LED13+: J27.1, U14.1 (ANODE)
/LED13-: J28.1, U14.2 (CATHODE)
/LED14+: J29.1, U15.1 (ANODE)
/LED14-: J30.1, U15.2 (CATHODE)
/LED15+: J31.1, U16.1 (ANODE)
/LED15-: J32.1, U16.2 (CATHODE)
GND: J50.1, J51.1, J52.1, J53.1, J54.1, J55.1, J56.1, J57.1, J58.1, J59.1, J60.1, J61.1, J62.1, J63.1, J64.1, J65.1, TH1.2, TH2.2, TH3.2, TH4.2, TH5.2, TH6.2, TH7.2, TH8.2, TH9.2, TH10.2, TH11.2, TH12.2, TH13.2, TH14.2, TH15.2, TH16.2
unnamed: J34.1, TH1.1
unnamed: J35.1, TH2.1
unnamed: J36.1, TH3.1
unnamed: J37.1, TH4.1
unnamed: J38.1, TH5.1
unnamed: J39.1, TH6.1
unnamed: J40.1, TH7.1
unnamed: J41.1, TH8.1
unnamed: J42.1, TH9.1
unnamed: J43.1, TH10.1
unnamed: J44.1, TH11.1
unnamed: J45.1, TH12.1
unnamed: J46.1, TH13.1
unnamed: J47.1, TH14.1
unnamed: J48.1, TH15.1
unnamed: J49.1, TH16.1
