letrend/UVen/hardware/uven2-sbm-120-uv-copper-base-16-leds/uven2-sbm-120-uv-copper-base-16-leds.kicad_pcb

## KiCad design hardware/uven2-sbm-120-uv-copper-base-16-leds/uven2-sbm-120-uv-copper-base-16-leds.kicad_pcb (continued)

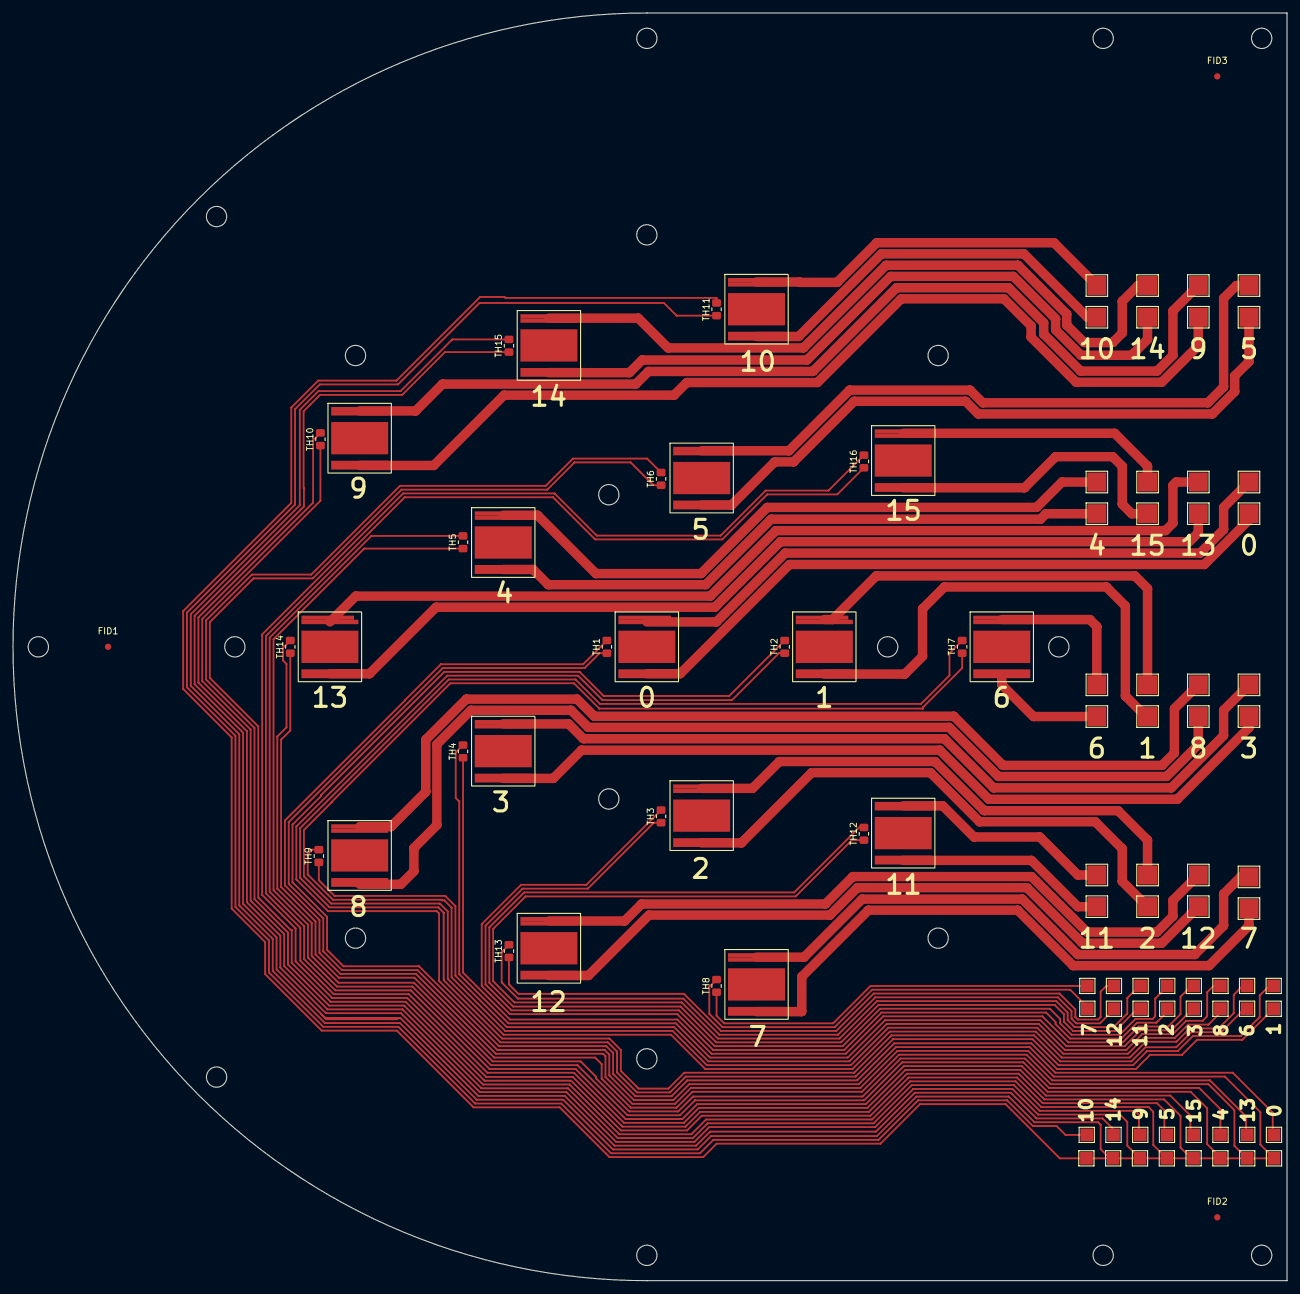
[picture p121: board uven2-sbm-120-uv-copper-base-16-leds.kicad_pcb from above]

Board: 2 copper layers, 201.0 x 200.0 mm, 119 parts (0 on the bottom side), 49 nets.
