letrend/UVen/hardware/uven2-mk2-interface-board/uven2-mk2-interface-board.kicad_pcb

## KiCad design hardware/uven2-mk2-interface-board/uven2-mk2-interface-board.kicad_pcb (2023-07-08)

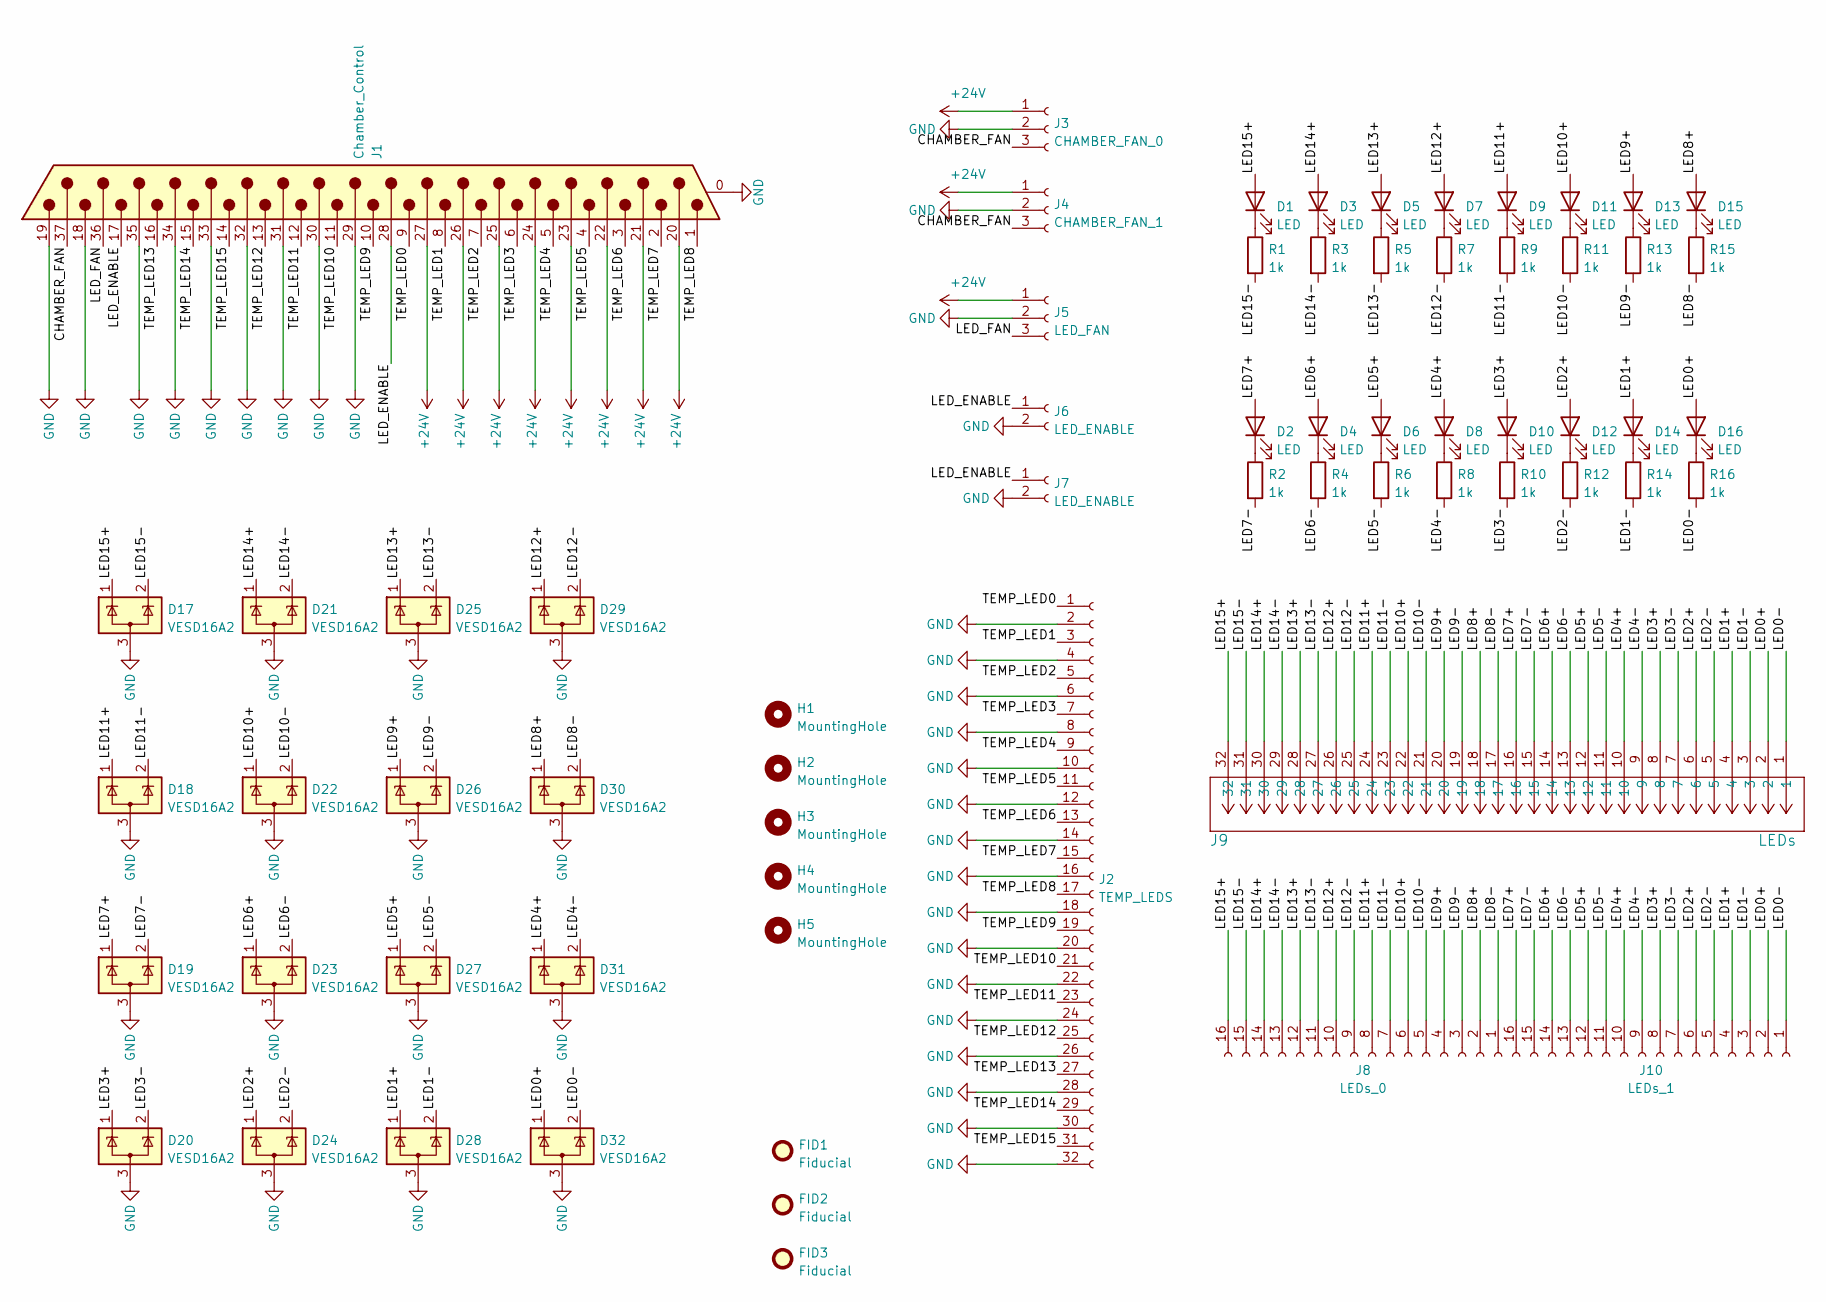
[picture p122: schematic uven2-mk2-interface-board.kicad_sch]

Parts:
D1, D2, D3, D4, D5, D6, D7, D8, D9, D10, D11, D12, D13, D14, D15, D16: LED; LED_0805_2012Metric_Pad1.15x1.40mm_HandSolder
D17, D18, D19, D20, D21, D22, D23, D24, D25, D26, D27, D28, D29, D30, D31, D32: VESD16A2; SOT-23
FID1, FID2, FID3: Fiducial; Fiducial_1mm_Dia_2.54mm_Outer_CopperTop
H1, H2, H3, H4, H5: MountingHole; MountingHole_3.2mm_M3
J1: Chamber_Control; DSUB-37_Female_Horizontal_P2.77x2.84mm_EdgePinOffset7.70mm_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
J2: TEMP_LEDS; PinHeader_2x16_P2.54mm_Vertical
J3: CHAMBER_FAN_0; PinHeader_1x03_P2.54mm_Vertical
J4: CHAMBER_FAN_1; PinHeader_1x03_P2.54mm_Vertical
J5: LED_FAN; PinHeader_1x03_P2.54mm_Vertical
J6, J7: LED_ENABLE; PinHeader_1x02_P2.54mm_Vertical
J8: LEDs_0; PinHeader_1x16_P2.54mm_Vertical
J9: LEDs; CONN_713-1436&slash_037-000_WAG
J10: LEDs_1; PinHeader_1x16_P2.54mm_Vertical
R1, R2, R3, R4, R5, R6, R7, R8, R9, R10, R11, R12, R13, R14, R15, R16: 1k; R_0603_1608Metric_Pad0.98x0.95mm_HandSolder

Connections:
+24V: J1.20, J1.21, J1.22, J1.23, J1.24, J1.25, J1.26, J1.27, J3.1, J4.1, J5.1
/CHAMBER_FAN: J1.37, J3.3, J4.3
/LED0+: D16.2 (A), D32.1 (K), J9.2, J10.2
/LED0-: D32.2 (K), J9.1, J10.1, R16.2
/LED1+: D14.2 (A), D28.1 (K), J9.4, J10.4
/LED1-: D28.2 (K), J9.3, J10.3, R14.2
/LED2+: D12.2 (A), D24.1 (K), J9.6, J10.6
/LED2-: D24.2 (K), J9.5, J10.5, R12.2
/LED3+: D10.2 (A), D20.1 (K), J9.8, J10.8
/LED3-: D20.2 (K), J9.7, J10.7, R10.2
/LED4+: D8.2 (A), D31.1 (K), J9.10, J10.10
/LED4-: D31.2 (K), J9.9, J10.9, R8.2
/LED5+: D6.2 (A), D27.1 (K), J9.12, J10.12
/LED5-: D27.2 (K), J9.11, J10.11, R6.2
/LED6+: D4.2 (A), D23.1 (K), J9.14, J10.14
/LED6-: D23.2 (K), J9.13, J10.13, R4.2
/LED7+: D2.2 (A), D19.1 (K), J9.16, J10.16
/LED7-: D19.2 (K), J9.15, J10.15, R2.2
/LED8+: D15.2 (A), D30.1 (K), J8.2, J9.18
/LED8-: D30.2 (K), J8.1, J9.17, R15.2
/LED9+: D13.2 (A), D26.1 (K), J8.4, J9.20
/LED9-: D26.2 (K), J8.3, J9.19, R13.2
/LED10+: D11.2 (A), D22.1 (K), J8.6, J9.22
/LED10-: D22.2 (K), J8.5, J9.21, R11.2
/LED11+: D9.2 (A), D18.1 (K), J8.8, J9.24
/LED11-: D18.2 (K), J8.7, J9.23, R9.2
/LED12+: D7.2 (A), D29.1 (K), J8.10, J9.26
/LED12-: D29.2 (K), J8.9, J9.25, R7.2
/LED13+: D5.2 (A), D25.1 (K), J8.12, J9.28
/LED13-: D25.2 (K), J8.11, J9.27, R5.2
/LED14+: D3.2 (A), D21.1 (K), J8.14, J9.30
/LED14-: D21.2 (K), J8.13, J9.29, R3.2
/LED15+: D1.2 (A), D17.1 (K), J8.16, J9.32
/LED15-: D17.2 (K), J8.15, J9.31, R1.2
/LED_ENABLE: J1.17, J1.28, J6.1, J7.1
/LED_FAN: J1.36, J5.3
/TEMP_LED0: J1.9, J2.1
/TEMP_LED1: J1.8, J2.3
/TEMP_LED2: J1.7, J2.5
/TEMP_LED3: J1.6, J2.7
/TEMP_LED4: J1.5, J2.9
/TEMP_LED5: J1.4, J2.11
/TEMP_LED6: J1.3, J2.13
/TEMP_LED7: J1.2, J2.15
/TEMP_LED8: J1.1, J2.17
/TEMP_LED9: J1.10, J2.19
/TEMP_LED10: J1.11, J2.21
/TEMP_LED11: J1.12, J2.23
/TEMP_LED12: J1.13, J2.25
/TEMP_LED13: J1.16, J2.27
/TEMP_LED14: J1.15, J2.29
/TEMP_LED15: J1.14, J2.31
GND: D17.3 (A), D18.3 (A), D19.3 (A), D20.3 (A), D21.3 (A), D22.3 (A), D23.3 (A), D24.3 (A), D25.3 (A), D26.3 (A), D27.3 (A), D28.3 (A), D29.3 (A), D30.3 (A), D31.3 (A), D32.3 (A), J1.0 (PAD), J1.18, J1.19, J1.29, J1.30, J1.31, J1.32, J1.33, J1.34, J1.35, J2.2, J2.4, J2.6, J2.8, J2.10, J2.12, J2.14, J2.16, J2.18, J2.20, J2.22, J2.24, J2.26, J2.28, J2.30, J2.32, J3.2, J4.2, J5.2, J6.2, J7.2
unnamed: D1.1 (K), R1.1
unnamed: D2.1 (K), R2.1
unnamed: D3.1 (K), R3.1
unnamed: D4.1 (K), R4.1
unnamed: D5.1 (K), R5.1
unnamed: D6.1 (K), R6.1
unnamed: D7.1 (K), R7.1
unnamed: D8.1 (K), R8.1
unnamed: D9.1 (K), R9.1
unnamed: D10.1 (K), R10.1
unnamed: D11.1 (K), R11.1
unnamed: D12.1 (K), R12.1
unnamed: D13.1 (K), R13.1
unnamed: D14.1 (K), R14.1
unnamed: D15.1 (K), R15.1
unnamed: D16.1 (K), R16.1

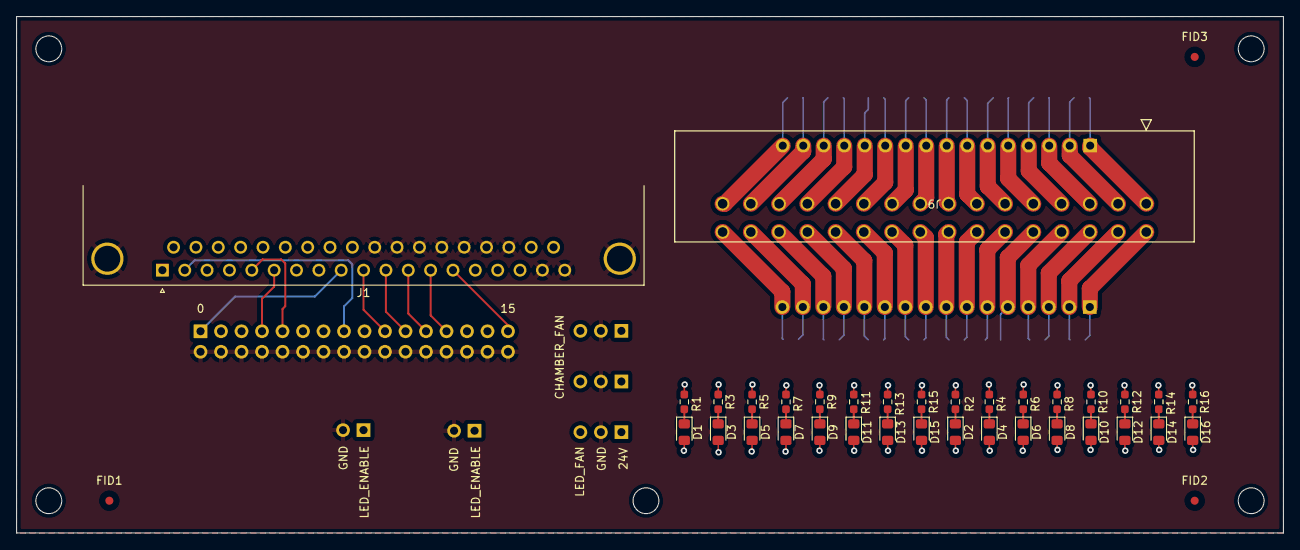
[picture p123: board uven2-mk2-interface-board.kicad_pcb from above]

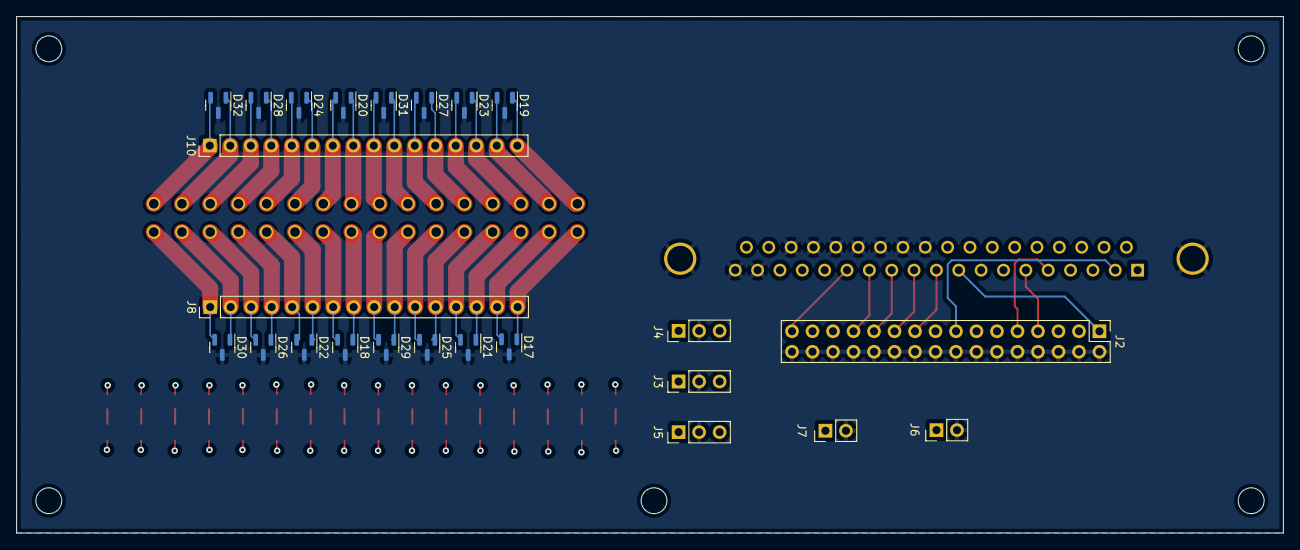
[picture p124: board uven2-mk2-interface-board.kicad_pcb from below]

Board: 4 copper layers, 157.0 x 64.0 mm, 66 parts (24 on the bottom side), 69 nets.
