letrend/UVen/src/uven2_mk2_teensy_tcp/pinConfig.h

#define LATCH0 6
#define LATCH1 7
#define CS0 37
#define CS1 36
#define LED_ENABLE 2
#define LED_SENS A0
#define TEMP_LED0 A1
#define TEMP_LED1 A2
#define TEMP_LED2 A3
#define TEMP_LED3 A4
#define TEMP_LED4 A5
#define TEMP_LED5 A6
#define TEMP_LED6 A7
#define TEMP_LED7 A8
#define TEMP_LED8 A9
#define TEMP_LED9 A10
#define TEMP_LED10 A11
#define TEMP_LED11 A12
#define TEMP_LED12 A13
#define TEMP_LED13 A14
#define TEMP_LED14 A15
#define TEMP_LED15 A16
#define TEMP_DRIVER A17
#define LED_SEL0 4
#define LED_SEL1 5
#define LED_DIAG_ENABLE_A 8
#define LED_DIAG_ENABLE_B 9
#define LED_DIAG_ENABLE_C 35
#define LED_DIAG_ENABLE_D 32
#define LED_DIAG_ENABLE_E 30
#define LED_DIAG_ENABLE_F 31
#define LED_DIAG_ENABLE_G 33
#define LED_DIAG_ENABLE_H 34
#define LED_LATCH 3
#define LED_FAN 28
#define CHAMBER_FAN 29
