letrend/UVen/src/thermistor_calibration.py

import numpy as np
import matplotlib.pyplot as plt
import csv
import sys

analogValues = []
temp = []
print("reading " + sys.argv[1])
with open(sys.argv[1]) as csvfile:
    # has_header = csv.Sniffer().has_header(csvfile.read(1024))
    # csvfile.seek(0)  # Rewind.
    reader = csv.reader(csvfile)
    # if has_header:
    next(reader)  # Skip header row
    for row in reader: # each row is a list
        analogValues.append(float(row[2]))
        temp.append(float(row[1]))

z = np.polyfit(analogValues, temp, 3)
print(analogValues)
print(temp)
plt.plot(analogValues, temp, 'ro')
xnew = np.linspace(0, 1023, 100)
y = []
for x in xnew:
    y.append(z[0]*x**3+z[1]*x**2+z[2]*x+z[3])
plt.xlabel("ADC[raw]")
plt.ylabel("Temp[C]")
plt.plot(xnew, y, 'g')

print("third order polynomial fit: ")
print(z)

plt.show()
