letrend/UVen/(commit log)

2021-03-04 with mounting holes, ready to order
    [sbm-120-uv-mount-B_Cu.gbr, sbm-120-uv-mount-B_Mask.gbr, sbm-120-uv-mount-B_Paste.gbr, sbm-120-uv-mount-B_SilkS.gbr, sbm-120-uv-mount-Edge_Cuts.gbr, sbm-120-uv-mount-F_Cu.gbr, sbm-120-uv-mount-F_Mask.gbr, sbm-120-uv-mount-F_Paste.gbr]
2021-03-15 smaller and square
    [sbm-120-uv-mount-B_Cu.gbr, sbm-120-uv-mount-B_Mask.gbr, sbm-120-uv-mount-B_Paste.gbr, sbm-120-uv-mount-B_SilkS.gbr, sbm-120-uv-mount-Edge_Cuts.gbr, sbm-120-uv-mount-F_Cu.gbr, sbm-120-uv-mount-F_Mask.gbr, sbm-120-uv-mount-F_Paste.gbr]
2021-03-16 draft main board
    [uven-mainboard.kicad_pcb, uven-mainboard.sch]
2021-03-16 more layout
    [uven-mainboard.kicad_pcb, uven-mainboard.sch]
2021-03-16 almoscht done
    [uven-mainboard.kicad_pcb, uven-mainboard.sch]
2021-03-16 with buttons
    [uven-mainboard.kicad_pcb, uven-mainboard.sch]
2021-03-19 done and ordered
    [sbm-120-uv-mount-B_Cu.gbr, sbm-120-uv-mount-B_Mask.gbr, sbm-120-uv-mount-B_Paste.gbr, sbm-120-uv-mount-B_SilkS.gbr, sbm-120-uv-mount-Edge_Cuts.gbr, sbm-120-uv-mount-F_Cu.gbr, sbm-120-uv-mount-F_Mask.gbr, sbm-120-uv-mount-F_Paste.gbr]
2021-04-08 with thermistor calibration values
    [thermistor_calibration.csv]
2021-04-08 with polynomial fit for thermistor
2021-04-16 with button dim control
2021-04-18 with over current/temp and trigger function
2021-04-22 with higher current limit
2021-05-08 that should do it
    [poti_hack.kicad_pcb, poti_hack.sch]
2021-05-09 v1 ordered on aisler
    [poti_hack-B_Cu.gbr, poti_hack-B_Mask.gbr, poti_hack-B_Paste.gbr, poti_hack-B_SilkS.gbr, poti_hack-Edge_Cuts.gbr, poti_hack-F_Cu.gbr, poti_hack-F_Mask.gbr, poti_hack-F_Paste.gbr]
2021-06-04 with i2c
2021-06-10 encoder button menu
2021-11-20 relay ativation, then intensity handled by i2c control
2021-11-28 debounce encoder
2021-12-28 schematics for one current controller
    [MTSM340UV2-F5120S-current-driver.kicad_pcb, MTSM340UV2-F5120S-current-driver.sch]
2021-12-29 course layout done
    [LM3407-current-controller.sch, MTSM340UV2-F5120S-current-driver.sch, power_conv.sch]
2021-12-30 layout almost done
    [LM3407-current-controller.sch, MTSM340UV2-F5120S-current-driver.kicad_pcb, MTSM340UV2-F5120S-current-driver.sch]
2021-12-30 layout done
    [LM3407-current-controller.sch, MTSM340UV2-F5120S-current-driver.kicad_pcb, MTSM340UV2-F5120S-current-driver.sch]
2021-12-30 ready for order
    [MTSM340UV2-F5120S-current-driver-B_Cu.gbr, MTSM340UV2-F5120S-current-driver-B_Mask.gbr, MTSM340UV2-F5120S-current-driver-B_Paste.gbr, MTSM340UV2-F5120S-current-driver-B_SilkS.gbr, MTSM340UV2-F5120S-current-driver-Edge_Cuts.gbr, MTSM340UV2-F5120S-current-driver-F_Cu.gbr, MTSM340UV2-F5120S-current-driver-F_Mask.gbr, MTSM340UV2-F5120S-current-driver-F_Paste.gbr]
2021-12-31 with step export
    [MTSM340UV2-F5120S-current-driver.kicad_pcb, MTSM340UV2-F5120S-current-driver.step]
2022-01-01 with correct fpc connector and pullup on enable
    [LM3407-current-controller.sch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]
2022-01-01 with 3d model fpc connector
    [MTSM340UV2-F5120S-current-driver.kicad_pcb]
2022-11-07 with draft uven 2d
    [uven-mainboard-B_Cu.gbr, uven-mainboard-B_Mask.gbr, uven-mainboard-B_Paste.gbr, uven-mainboard-B_SilkS.gbr, uven-mainboard-Edge_Cuts.gbr, uven-mainboard-F_Cu.gbr, uven-mainboard-F_Mask.gbr, uven-mainboard-F_Paste.gbr]
2022-11-12 pcb ordered in aisler
    [uven-mainboard.kicad_pcb, uven-mainboard.kicad_sch]
2022-11-27 with temp calibration
    [thermistor_calibration.csv]
2023-01-29 led control draft
    [poti_hack.kicad_pcb, poti_hack.kicad_sch]
2023-01-29 temp control draft
    [thermistor_calibration.csv]
2023-03-15 with tft display working and showing temperature
2023-04-05 spi slave draft for arduino due
2023-04-07 copper base board draft
    [sbm-120-uv-copper-base-board.kicad_pcb, sbm-120-uv-copper-base-board.kicad_sch]
2023-04-07 proper frames between wio and due
2023-04-07 plotting all three temperatures
2023-04-08 with coms reset via pin
2023-04-08 with communication recovery by resetting arduino due
2023-04-24 with actual uven2 led positions
2023-04-29 more mounting holes
    [uven2-sbm-120-uv-copper-base-16-leds.kicad_pcb, uven2-sbm-120-uv-copper-base-16-leds.kicad_sch]
2023-04-29 draft uven2 mk2 mainboard
    [led_driver.kicad_sch, uven2-mk2-mainboard.kicad_pcb, uven2-mk2-mainboard.kicad_sch, uven2-sbm-120-uv-copper-base-16-leds.step]
2023-04-30 with current limiting switch
    [led_driver.kicad_sch, uven2-mk2-mainboard.kicad_pcb, uven2-mk2-mainboard.kicad_sch]
2023-04-30 with wago connector
    [led_driver.kicad_sch, uven2-mk2-mainboard.kicad_pcb, uven2-mk2-mainboard.kicad_sch]
2023-05-08 with bom
    [uven2_mk2.ods]
2023-05-08 more parts
    [uven2_mk2.ods]
2023-05-09 with different mosfet
    [led_driver.kicad_sch, uven2-mk2-mainboard.kicad_pcb, uven2-mk2-mainboard.kicad_sch, uven2_mk2.ods]
2023-05-10 with chamber control
    [led_driver.kicad_sch, uven2-mk2-mainboard.kicad_sch, uven2_mk2.ods]
2023-05-11 schematics done
    [led_driver.kicad_sch, uven2-mk2-mainboard.kicad_pcb, uven2-mk2-mainboard.kicad_sch, uven2_mk2.ods]
2023-05-15 layout led driver almost done
    [led_driver.kicad_sch, uven-mainboard.kicad_sch, uven2-mk2-mainboard.kicad_pcb, uven2-mk2-mainboard.kicad_sch, uven2_mk2.ods]
2023-05-15 layout almost finished
    [led_driver.kicad_sch, uven2-mk2-mainboard.kicad_pcb, uven2-mk2-mainboard.kicad_sch]
2023-05-16 layout finished
    [led_driver.kicad_sch, uven2-mk2-mainboard.kicad_pcb, uven2-mk2-mainboard.kicad_sch]
2023-05-16 with thermistors
    [uven2-sbm-120-uv-copper-base-16-leds.kicad_pcb, uven2-sbm-120-uv-copper-base-16-leds.kicad_sch]
2023-05-16 interface board done
    [uven2-mk2-interface-board.kicad_pcb, uven2-mk2-interface-board.kicad_sch, uven2_mk2.ods]
2023-05-20 uven pocket layout almost finished
    [led_driver.kicad_sch, uven-mainboard.kicad_sch, uven-pocket-main-board.kicad_pcb, uven-pocket-main-board.kicad_sch, uven-pocket.ods, uven2-mk2-mainboard.kicad_sch, uven2_mk2.ods]
2023-05-21 single led copper base + uven pocket finished
    [led_driver.kicad_sch, sbm-120-uv-copper-base-board.kicad_pcb, sbm-120-uv-copper-base-board.kicad_sch, uven-pocket-main-board.kicad_pcb, uven-pocket-main-board.kicad_sch, uven-pocket.ods]
2023-06-05 with current sens control loop
2023-06-06 calibration uvenpocket thermistor
    [thermistor_calibration_pocket_mk2.csv]
2023-06-08 with step
    [sbm-120-uv-copper-base-board.step]
2023-06-08 ramp up to avoid over current latch
2023-06-09 two leds closed loop
2023-06-17 better current control and tec enable pins for relays
2023-06-17 with separate button for emergency off and release
2023-07-08 ordered on jlcpcb
    [led_driver.kicad_sch, uven2-mk2-interface-board.kicad_pcb, uven2-mk2-interface-board.kicad_sch, uven2-mk2-mainboard.kicad_pcb, uven2-mk2-mainboard.kicad_sch, uven2-sbm-120-uv-copper-base-16-leds.kicad_pcb, uven2-sbm-120-uv-copper-base-16-leds.kicad_sch, uven2_mk2.ods]
2023-07-30 serial coms working between teensy and wio
2023-08-12 with tcp teensy
2023-08-12 full range fan
2023-08-12 with current calibration
2023-08-14 current contro global
2023-08-15 with temp calbration
    [uven2_mk2.csv]
2023-08-15 fixed current conversion, crash of gui on disconnect
    [uven2_mk2_teensy_tcp.ino, uven_control_center_gui.hpp]
2023-08-15 full power test, unlatch leds on interock event
2023-08-20 each led current tuned
2023-08-25 more aggressive current controller, overtemp, scale led fan wrt led temp max
2023-08-27 with chamber fan control
2023-08-28 timer also ready
2023-09-01 with timer showing correctly and adjusted current limits
    [uven2_mk2_teensy_tcp.ino, uven2_mk2_wio_terminal_guislicer.ino]
2023-09-16 with 4000mA current range
2023-09-17 power supply seems to be maxed out >3.5A, limiting current
2024-04-27 uven only
    [LM3407-current-controller.sch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]
2024-04-27 fixed 3.3V trace missing, added footage
    [led_driver.kicad_sch, uven2-mk2-mainboard.kicad_pcb, uven2-mk2-mainboard.kicad_sch]
